sky4walk/BrausteuerungV4/Hardware/kicad/BrausteuerungV4_Prototypplatine/BrausteuerungV4_Prototypplatine.jpg

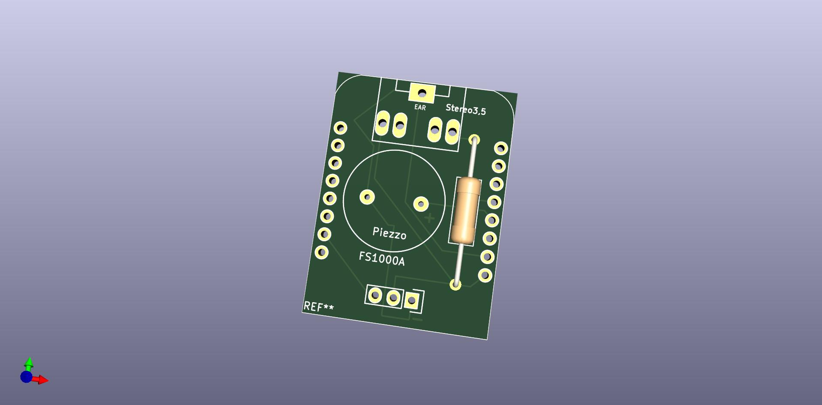
Hardware/kicad/BrausteuerungV4_Prototypplatine/BrausteuerungV4_Prototypplatine.jpg
