sky4walk/BrausteuerungV4/Documents/Bilder/WifiSetup1.jpg

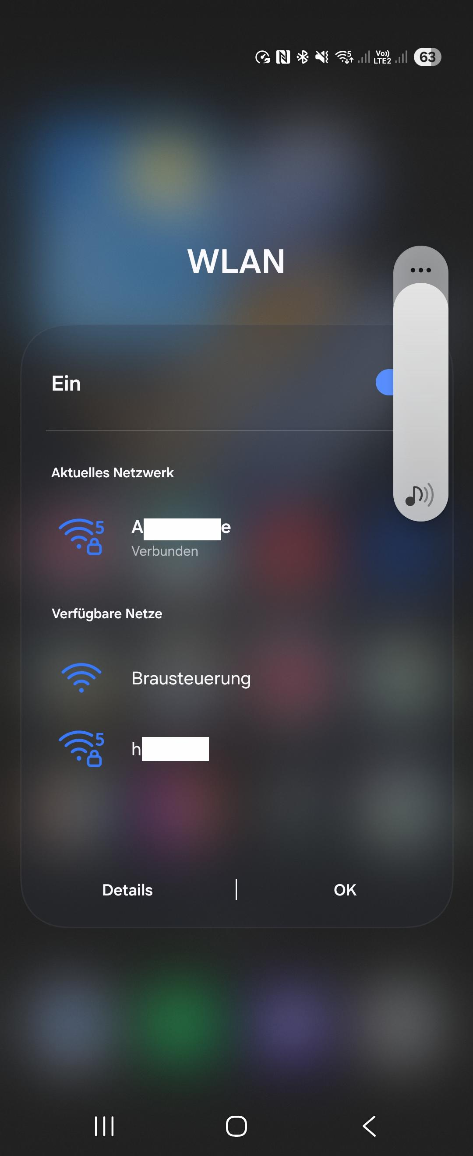
Documents/Bilder/WifiSetup1.jpg
