sky4walk/BrausteuerungV4/Readme.md

https://itzwieseltal.wordpress.com/2023/12/06/esp8266-brausteuerung/
