sky4walk/BrausteuerungV4/Documents/BrewBrick_Requirements.docx

🍺

BrewBrick

ESP8266 Brausteuerung

Technische Anforderungsdokumentation • Version 4.0.0

# 1. Projektübersicht

BrewBrick ist eine vollständige Heimbrausteuerung auf Basis des Wemos D1 Mini (ESP8266). Die Steuerung regelt die Heiztemperatur über einen PID-Regler und schaltet eine Funksteckdose per 433-MHz-Signal. Das Web-Interface ist vollständig im Flash des ESP gespeichert und über jeden Browser erreichbar.

Eigenschaft | Wert
Projektname | BrewBrick
Version | 4.0.0
Hardware | Wemos D1 Mini (ESP8266)
Web-Interface | http://brewbrick.local
AP-SSID | BrewBrick (offen, kein Passwort)
Projektseite | https://itzwieseltal.wordpress.com/2023/12/06/esp8266-brausteuerung/

# 2. Hardware

## 2.1 Microcontroller

Parameter | Wert
Board | LOLIN(WEMOS) D1 R2 & mini
Chip | ESP8266
Flash | 4MB (FS: 2MB, OTA: ~1MB)
Upload Speed | 921600 Baud
SSL | Basic SSL ciphers
Taktfrequenz | 80 MHz

## 2.2 Pin-Belegung

GPIO | Funktion
GPIO4 / D2 | DS18B20 Temperatursensor (OneWire)
GPIO0 / D3 | Buzzer (Piezo)
GPIO15 / D8 | RCSwitch 433MHz Sender

## 2.3 Angeschlossene Geräte

- DS18B20 Temperatursensor (OneWire, parasitär oder mit Pullup)
- Piezo-Buzzer für akustische Signale
- 433-MHz-Sender für Funksteckdose
- Funksteckdose mit Relais (EIN/AUS per RC-Signal)

# 3. Software & Bibliotheken

## 3.1 Arduino IDE Einstellungen

Board-Paket: esp8266 by ESP8266 Community v3.1.2

Board: LOLIN(WEMOS) D1 R2 & mini

Flash Size: 4MB (FS:2MB OTA:~1019KB)

SSL Support: Basic SSL ciphers (lower ROM, faster boot)

Upload Speed: 921600

## 3.2 Bibliotheken (Core — Teil des ESP8266-Pakets v3.1.2)

- ESP8266WiFi
- ESP8266WebServer
- ESP8266mDNS
- LittleFS
- ESP8266HTTPUpdateServer

## 3.3 Externe Bibliotheken

Bibliothek | Version / Autor
OneWire | v2.3.7 — Paul Stoffregen
DallasTemperature | v3.9.0 — Miles Burton
PID | v1.2.0 — Brett Beauregard
RCSwitch | v2.6.4 — sui77
ArduinoJson | v6.21.5 — Benoit Blanchon (unbedingt v6.x!)

# 4. LittleFS Dateisystem

Das LittleFS-Dateisystem belegt 2MB des Flash-Speichers und enthält alle persistenten Daten:

Datei | Inhalt
/wlan.json | WLAN Credentials (geschützt, nicht löschbar per API)
/config.json | RCSwitch Codes, PID-Parameter, alle Einstellungen
/rezept.bml | Aktuell geladenes Braurezept (BML-Format)
/index.html | Optionale Web-UI (überschreibt PROGMEM-Version)
/log.csv | Temperaturlog (wird beim Brauen geschrieben)

# 5. Web-Interface

## 5.1 Erreichbarkeit

- WLAN-Modus: http://brewbrick.local oder IP-Adresse
- AP-Modus: http://192.168.4.1 (SSID: BrewBrick, offen)
- mDNS-Name: brewbrick.local

## 5.2 Tabs

Tab | Funktion
Steuerung | Temperaturanzeige, Timer, Heizungsstatus, Live-Chart
Rezept Erstellen | BML-Editor, BeerXML-Import, Rezept übernehmen
Einstellungen | RCSwitch, PID, alle Parameter konfigurieren
⚙ Tools (Link) | HTML-Upload, OTA-Firmware, Backup/Restore, Reset
📝 Rezept Erstellen (Link) | BML-Generator auf GitHub Pages
🧮 Rechner (Link) | Braurechner auf GitHub Pages

## 5.3 Steuerung-Tab — Anzeige

- Ist-Temperatur, Soll-Temperatur, Gradient (°C/min), Zustand
- Heizungsanzeige (EIN/AUS) mit PID-Prozentsatz
- Live-Temperaturkurve (Canvas-Chart aus Flash-Log)
- Grüne Linie = Ist-Temperatur
- Gestrichelte Amber-Linie = Solltemperatur
- Rote Fläche = Heizleistung (PID-Output)
- Vertikale Linien = Rast-Wechsel
- Timer (verbleibend / gesamt) wenn Rast läuft
- Halt-Banner mit "Weiter" und "🔕 Stumm" Button
- Sensor-Fehler Banner (rot) wenn Sensor getrennt

## 5.4 API-Endpunkte

Endpunkt | Funktion
GET /api/status | Live-Status als JSON
POST /api/start | Rezept starten {von: nr}
POST /api/stop | Stoppen
POST /api/weiter | Halt bestätigen → nächste Rast
POST /api/call/mute | Piepen für aktuelle Rast stumm schalten
GET /api/config | Einstellungen lesen
POST /api/config | Einstellungen speichern
POST /api/heizung-test | Heizung testen {an: bool}
GET /api/log | Log als JSON (für Chart)
POST /api/log/reset | Log löschen
GET /api/log/download | Log als CSV herunterladen
GET /api/settings/backup | config.json herunterladen
GET /api/files | Dateilisting (wlan.json ausgeblendet)
POST /api/files/delete | Datei löschen (?name=datei.ext)
POST /api/rezept/loeschen | Rezept löschen
POST /api/wlan/reset | Komplett-Reset (alle Dateien löschen)
GET /api/sysinfo | System-Info
POST /upload/bml | BML hochladen
POST /upload/config | Config hochladen / Restore
POST /upload/html | HTML hochladen (.html oder .gz)
GET /update | OTA Firmware (admin/brau2024)
GET /tools | Tools-Seite (PROGMEM)

# 6. Brau-Logik

## 6.1 Zustandsmaschine

Zustand | Beschreibung
GESTOPPT (0) | Kein Rezept aktiv, Heizung aus
AUFHEIZEN (1) | Heizt auf Solltemperatur, Timer noch nicht gestartet
RAST_LAEUFT (2) | Solltemperatur erreicht, Timer läuft
WARTEN_HALT (3) | Timer abgelaufen, wartet auf "Weiter" (call=true)

## 6.2 Rast-Ablauf

- Aufheizen bis Solltemperatur erreicht (tempAktuell >= pidSetpoint)
- Timer startet sofort — kein manueller Eingriff nötig
- Timer läuft ab → call=true: 3x Piepen + warten auf "Weiter"
- "Weiter" klicken → nächste Rast startet
- call=false: sofort nächste Rast ohne Piepen
- Letzte Rast abgeschlossen: 5x Piepen

## 6.3 Halt / Call

Halt und Call werden als ein gemeinsamer Parameter behandelt. Ein Schieber im Rezept-Editor setzt beide gleichzeitig. Bedeutung:

- Call=false: Timer läuft ab → nächste Rast automatisch
- Call=true: Timer läuft ab → 3x Piepen → warten auf "Weiter"

## 6.4 Akustische Signale

Ereignis | Signal
Boot / Bereit (WLAN) | 2x Piepen
AP-Modus aktiv | 1x langer Piepton
Temperatur erreicht, Call=true | 3x Piepen (+ alle 10s Wiederholung)
Brauprogramm abgeschlossen | 5x Piepen
Sensor getrennt (nach 10s) | 5x Piepen
Stumm-Button gedrückt | Piepen gestoppt bis nächste Rast

## 6.5 Browser-Ton

- Web Audio API — kein Plugin nötig, funktioniert auf allen modernen Browsern
- Gleiche Logik wie ESP-Buzzer: 3x beim Rast-Ende, alle 10s Wiederholung
- 🔕 Stumm-Button stoppt Browser-Ton und ESP-Piepen für aktuelle Rast
- Erfordert einmaligen Klick auf die Seite (Browser-Policy)

# 7. PID-Regelung

## 7.1 Parameter

Parameter | Standardwert / Beschreibung
Kp | 5.0 — Proportionalanteil
Ki | 0.05 — Integralanteil
Kd | 10.0 — Differentialanteil
PID-Fenster | 30 Sekunden (konfigurierbar 5–120s)
PID-Schwellwert | 5°C — unter (Soll - 5°C) → 100% Leistung
Sample Time | 2000ms

## 7.2 Schwellwert-Logik

- Wenn (Soll - Ist) > Schwellwert → 100% Leistung (kein PID)
- Wenn (Soll - Ist) <= Schwellwert → PID übernimmt
- Schwellwert = 0 → PID regelt von Anfang an
- Ziel: Vermeidung von D-Anteil-Bremsung beim Aufheizen

## 7.3 Rast-spezifische PID-Werte

- Jede Rast kann eigene PID-Werte haben (Toggle "Eigene PID-Werte")
- Flag OwnPid=true im BML → Rast-Werte werden verwendet
- Flag OwnPid=false → globale Einstellungswerte werden verwendet
- PID wird bei jeder neuen Rast zurückgesetzt (MANUAL → AUTOMATIC)

## 7.4 MaxGradient

- Pro Rast einstellbarer maximaler Temperaturanstieg in °C/min
- MaxGradient = 0 → keine Begrenzung, volle Leistung erlaubt
- MaxGradient > 0 → PID-Output wird proportional reduziert wenn Gradient zu hoch

# 8. RCSwitch / Funksteckdose

## 8.1 Standardwerte

Parameter | Standardwert
Code EIN | 1631343
Code AUS | 1631342
Protokoll | 1
Pulslänge | 315 µs
Bits | 24
Sendeversuche | 15
Wiederholungsintervall | 10 Sekunden
Relais Mindest-Schaltzeit | 200ms (Relais-Schutz)

## 8.2 Signal-Wiederholung

- Alle 10 Sekunden wird das aktuelle Signal (EIN oder AUS) wiederholt
- Gilt auch im Standby: immer AUS-Signal senden
- Verhindert falschen Zustand bei verlorenen Funksignalen

## 8.3 Relais-Schutz

- Mindest-Schaltzeit verhindert zu schnelles Schalten des Relais
- Standard: 200ms — verhindert Verschleiß bei schnellem PID-Takten
- Konfigurierbar 0–5000ms in den Einstellungen

# 9. Temperatursensor

- DS18B20 OneWire-Sensor an GPIO4 / D2
- Messintervall: 2 Sekunden
- Gradient wird aus den letzten 6 Messungen (12s) berechnet in °C/min
- Sensor-Fehler nach 10s ohne gültige Messung:
- Heizung wird sofort abgeschaltet
- 5x Piepen als Alarm
- Rotes Banner im Browser
- Sensor wieder eingesteckt → automatische Erkennung, kein Neustart nötig

# 10. Temperaturlogging

- Logging startet automatisch beim ersten Rast-Start
- Logging stoppt beim Stop oder nach letzter Rast
- Schreibt alle 10 Sekunden in /log.csv auf LittleFS
- Format: Zeit_s;Temp_C;Soll_C;PID_Pct;Rast
- 💾 Log Button im Browser → direkter CSV-Download
- ↺ Reset löscht die Log-Datei und setzt den Chart zurück
- Log überlebt Neustart (bleibt bis manuell gelöscht oder Reset)

# 11. Rezept-Format (BML)

## 11.1 BML-Datei

Das Rezept wird im BML-Format (XML-basiert) gespeichert. BML steht für Brau-Markup-Language und ist kompatibel mit der MikroSikaru App.

## 11.2 Rast-Parameter

Parameter | Beschreibung
Name | Rastname (leer → automatisch "Rast N")
On | true/false — Rast aktiv
Halt/Call | true/false — Piepen + warten am Rast-Ende
SollTemp | Zieltemperatur in °C
Time | Rastdauer in Minuten
MinTemp / MaxTemp | Toleranzbereich (±°C)
MaxGradient | Max. Aufheizrate in °C/min (0 = unbegrenzt)
OwnPid | true = eigene PID-Werte verwenden
Kp / Ki / Kd | Rast-spezifische PID-Parameter
Info | Notizfeld für Brauer

## 11.3 Rezept-Editor

- Direkt integriert im Tab "Rezept Erstellen"
- Bis zu 16 Rasten erstellbar
- BML-Import und -Export
- BeerXML-Import (konvertiert Mash Steps automatisch)
- "Rezept übernehmen" lädt BML direkt auf den ESP
- Beim Tab-Öffnen werden aktuelle ESP-Rasten automatisch geladen

# 12. WLAN & Netzwerk

- WLAN-Config in /wlan.json (geschützt)
- Verbindungsversuch beim Start: 15 Sekunden Timeout
- Kein WLAN gefunden → AP-Modus: SSID "BrewBrick" (offen)
- AP-IP: 192.168.4.1
- WLAN-Einrichtung über Web-Formular im AP-Modus
- mDNS-Hostname: brewbrick → http://brewbrick.local
- WLAN-Reset: /tools → "⚠ Alles löschen & Neustart" (löscht alle Dateien)

# 13. OTA-Updates & Werkzeuge

## 13.1 Firmware OTA

- URL: http://brewbrick.local/update (Login: admin / brau2024)
- Auch über /tools → "⚡ Flashen" Button
- Arduino IDE: Sketch → Exportiere kompilierte Binärdatei → .bin hochladen
- Sketch-Größe ~400KB < OTA-Bereich 1019KB → passt

## 13.2 HTML-Update

- URL: http://brewbrick.local/tools → "⬆ Upload" Button
- Oder per curl: curl -X POST http://brewbrick.local/upload/html -F "file=@index.html"
- LittleFS-Version hat Vorrang vor eingebetteter PROGMEM-Version
- "↺ Reset" in /tools aktiviert wieder die PROGMEM-Version

## 13.3 Flash-Script (Linux)

flash_esp.sh im Sketch-Verzeichnis sucht automatisch die neueste .bin Datei und den USB-Port:

Verwendung: ./flash_esp.sh

Erkennt: /dev/ttyUSB0, /dev/ttyUSB1, /dev/ttyACM0, /dev/ttyACM1

Tool: esptool (sudo apt install esptool)

## 13.4 File-Management per curl

Dateilisting: curl http://brewbrick.local/api/files

Datei löschen: curl -X POST "http://brewbrick.local/api/files/delete?name=log.csv"

Log herunterladen: curl http://brewbrick.local/api/log/download -o log.csv

Config Backup: curl http://brewbrick.local/api/settings/backup -o config.json

Config Restore: curl -X POST http://brewbrick.local/upload/config -F "file=@config.json"

# 14. Erstinbetriebnahme

- Sketch mit Arduino IDE kompilieren und per USB flashen
- Board: LOLIN(WEMOS) D1 R2 & mini
- Flash Size: 4MB (FS:2MB OTA:~1019KB)
- SSL: Basic SSL ciphers
- ESP startet im AP-Modus: SSID "BrewBrick"
- Mit "BrewBrick" verbinden (kein Passwort)
- Browser öffnen: http://192.168.4.1
- Setup-Seite erscheint: index.html hochladen
- WLAN konfigurieren: SSID und Passwort eingeben
- ESP verbindet sich → http://brewbrick.local aufrufen
- Einstellungen: RCSwitch-Codes, PID-Parameter konfigurieren
- Rezept erstellen oder BML-Datei hochladen
- Sud starten! 🍺

# 15. Hinweise & Einschränkungen

- IRAM-Auslastung ~94% — stabil, aber wenig Puffer für weitere Libraries
- RC433 ist ein One-Way-Protokoll — keine Rückmeldung ob Steckdose empfangen hat
- Temperaturlog: Flash-Speicher hat ~100.000 Schreibzyklen — bei 10s Intervall ~16 Jahre Lebensdauer
- mDNS (brewbrick.local) auf Android nicht immer zuverlässig — IP-Adresse als Fallback verwenden
- Browser-Ton erfordert einmaligen Klick auf die Seite (Browser-Autoplay-Policy)
- OTA-Update schreibt in den OTA-Bereich — LittleFS-Dateien bleiben erhalten

ESP8266 Brausteuerung | /

BrewBrick v4.0.0 — Technische Anforderungsdokumentation
