sky4walk/BrausteuerungV4/Documents/ArduinoIDE-ESP8266.odp

  ESP8266 mit der Arduino IDE entwickeln
  info@AndreBetz.de

## Slide 2

Installationspackete

- http://www.arduino.org/downloads Arduino IDE

- http://arduino.esp8266.com/stable/package_esp8266com_index.json Arduino AddOn

- http://esp8266.com/arduino ESP8266 Projektverzeichnis

- https://github.com/esp8266/Arduino

- https://github.com/esp8266/Arduino/releases/download/2.3.0/esp8266-2.3.0.zip ESP8266 Bibliotheken

- http://esp8266.github.com/Arduino/versions/2.3.0/

- https://github.com/esp8266/Arduino/releases/download/2.3.0/win32-xtensa-lx106-elf-gb404fb9-2.tar.gz Windows Compiler für ESP8266

## Slide 3

Unter Datei→Voreinstellgen den Link unten einfügen

http://arduino.esp8266.com/stable/package_esp8266com_index.json

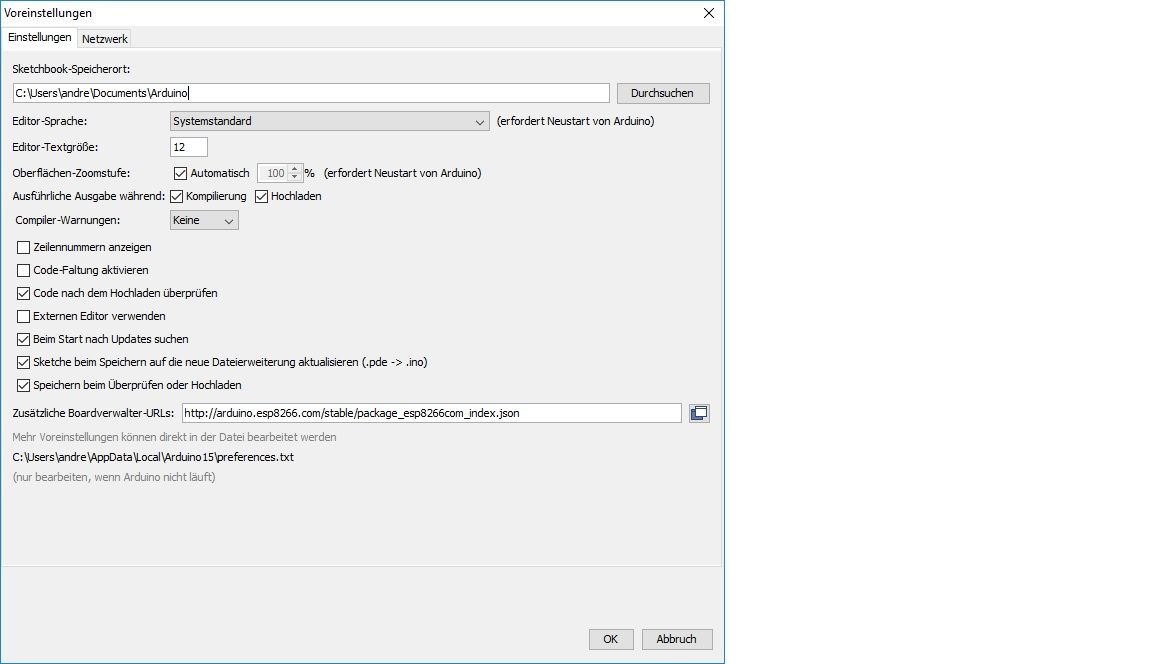
[picture p3: figure]

## Slide 4

Werkzeuge→Board→Boardverwalter

Esp8266 installieren

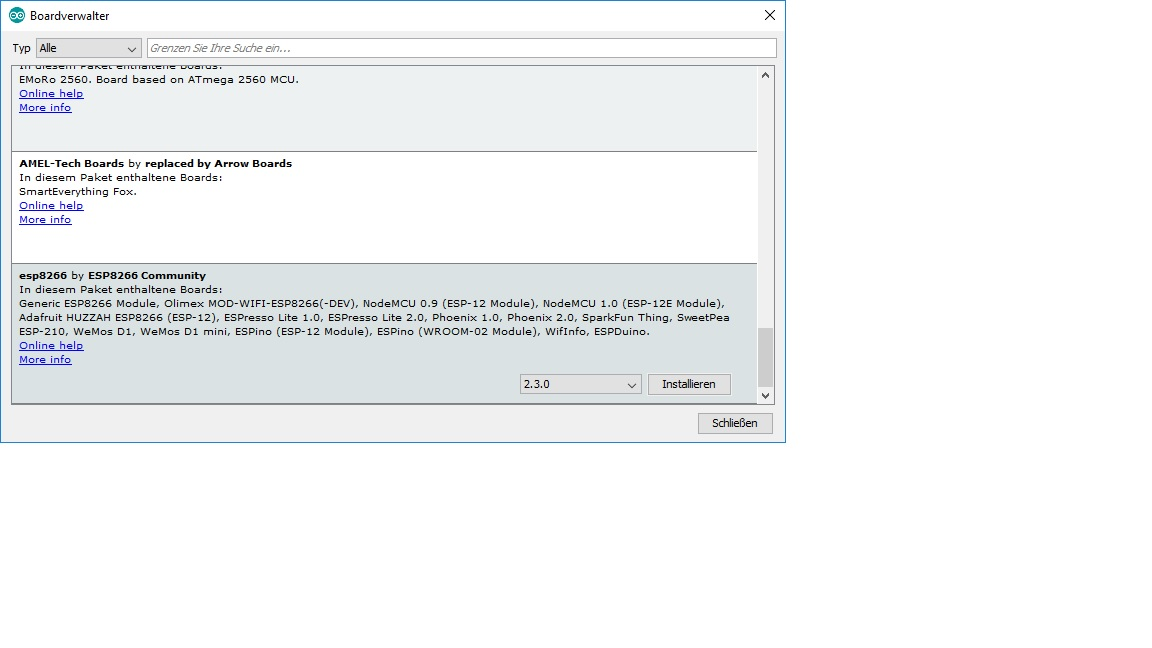
[picture p4: figure]

## Slide 5

Auswahl des ESP8266 NodeMCU Boardes

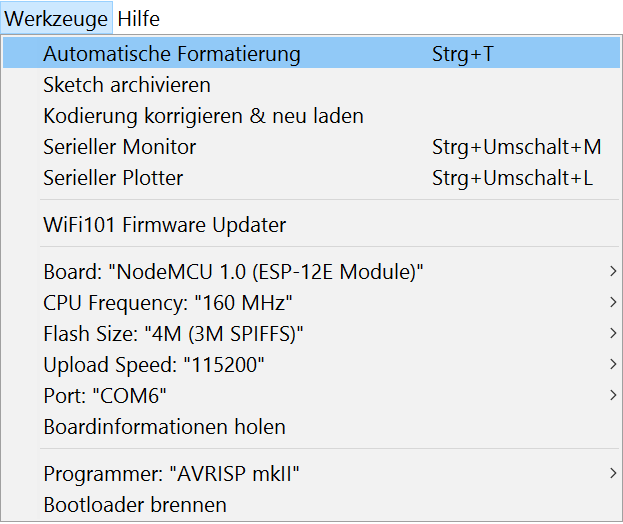
[picture p5: figure]
