sky4walk/BrausteuerungV4/Case/Box.png

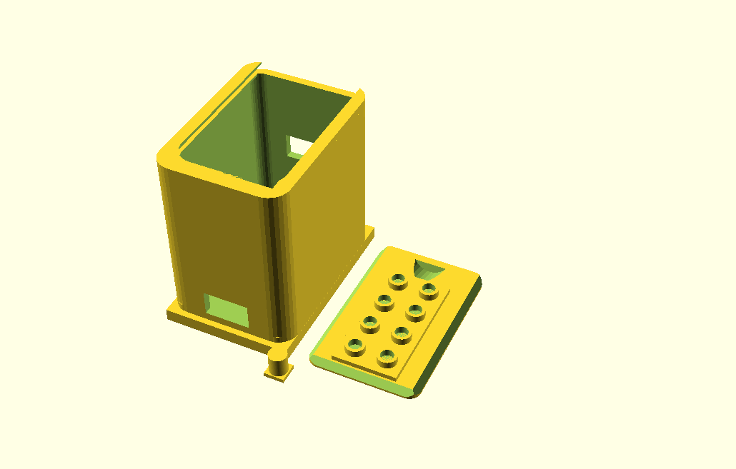
Case/Box.png
