sky4walk/BrausteuerungV4/Case/holder.png

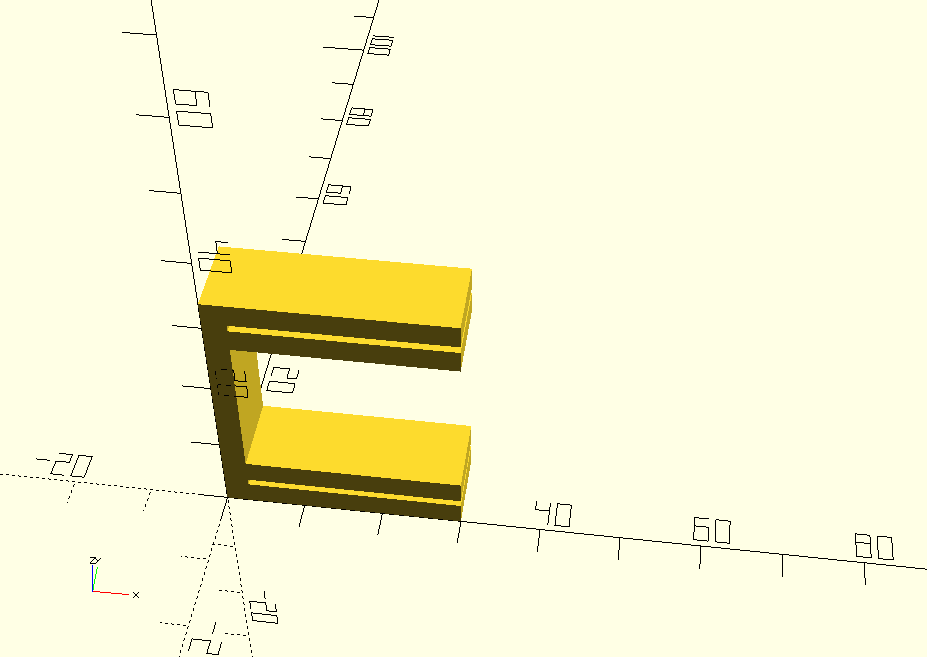
Case/holder.png
