sky4walk/BrausteuerungV4/Documents/Bilder/Brausteuerung01.png

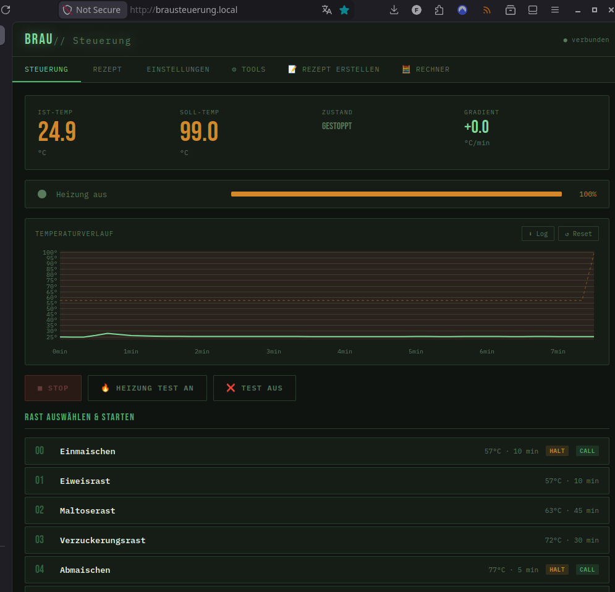
Documents/Bilder/Brausteuerung01.png
