sky4walk/BrausteuerungV4/Documents/Bilder/Brausteuerung02.png

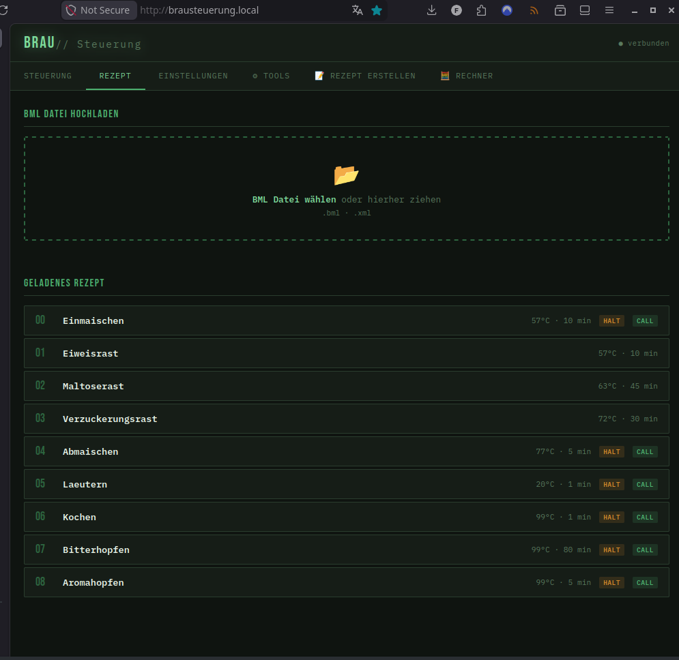
Documents/Bilder/Brausteuerung02.png
