sky4walk/BrausteuerungV4/Documents/Bilder/Brausteuerung03.png

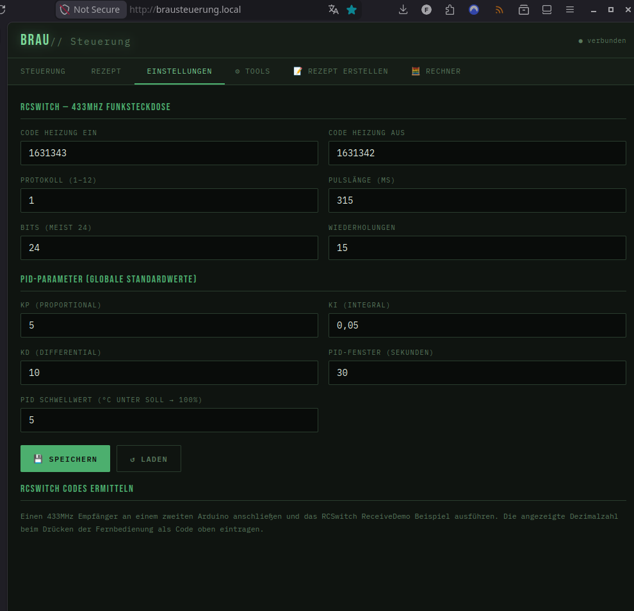
Documents/Bilder/Brausteuerung03.png
