sky4walk/BrausteuerungV4/Documents/Bilder/Brausteuerung04.png

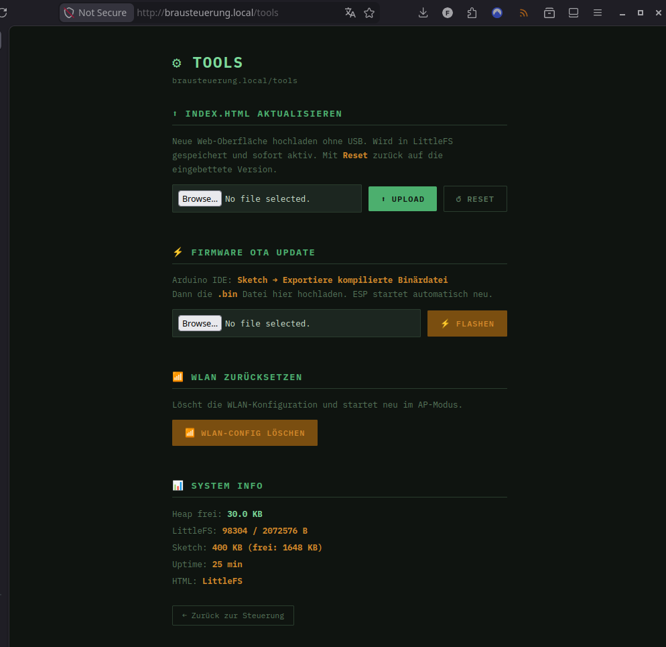
Documents/Bilder/Brausteuerung04.png
