sky4walk/BrausteuerungV4/Documents/Bilder/Brausteuerung05.png

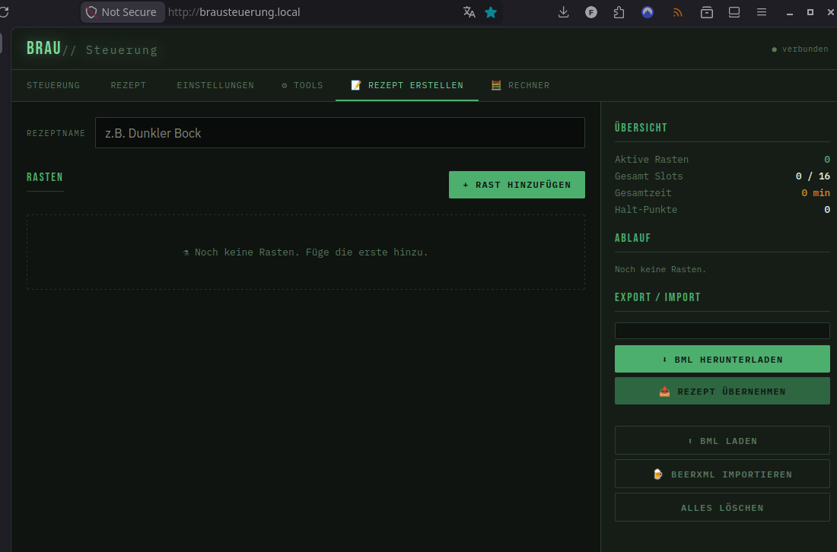
Documents/Bilder/Brausteuerung05.png
