sky4walk/BrausteuerungV4/Documents/Bilder/Brausteuerung06.png

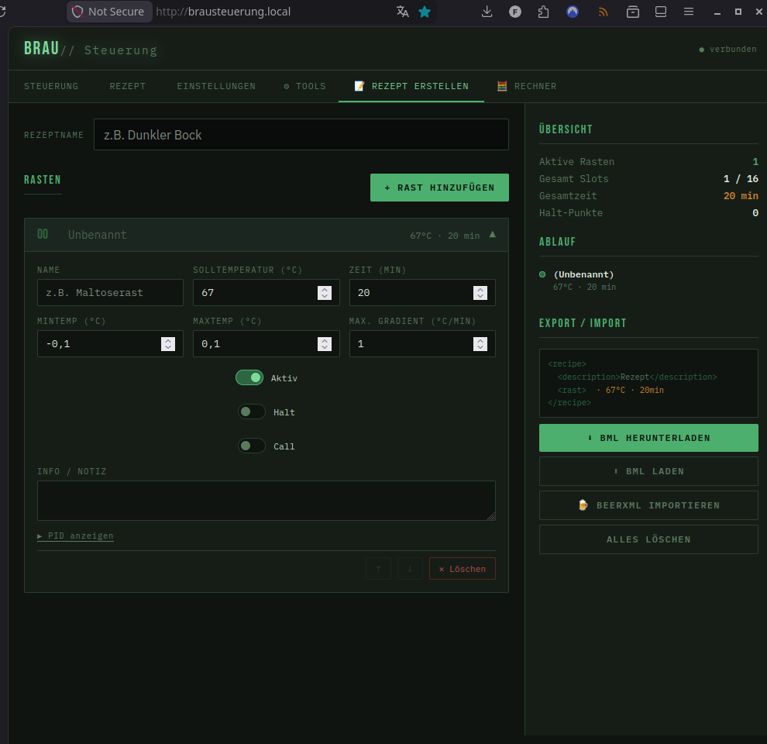
Documents/Bilder/Brausteuerung06.png
