sky4walk/BrausteuerungV4/Documents/Bilder/Brausteuerung07.png

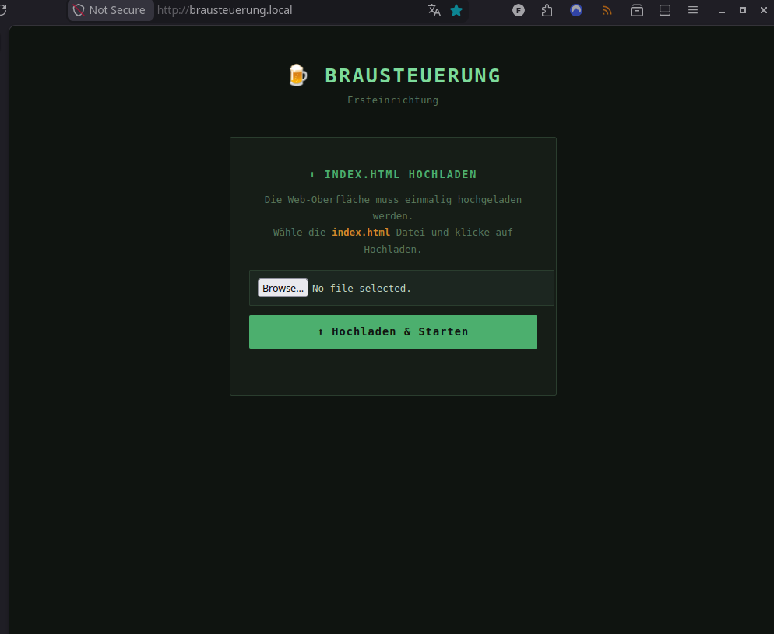
Documents/Bilder/Brausteuerung07.png
