sky4walk/BrausteuerungV4/Documents/Bilder/Brausteuerung08.png

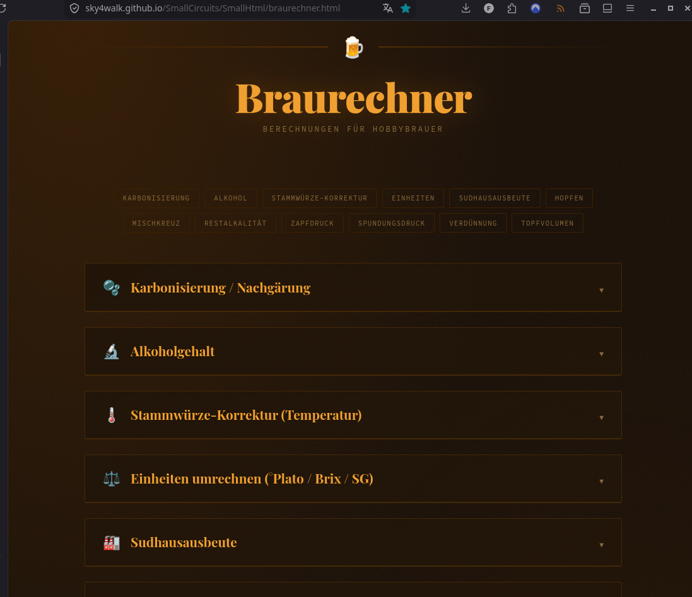
Documents/Bilder/Brausteuerung08.png
