sky4walk/BrausteuerungV4/Hardware/Dallas-DS18B20.jpg

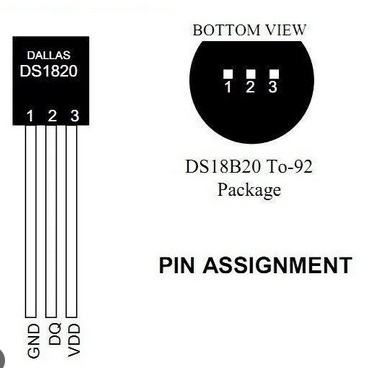
Hardware/Dallas-DS18B20.jpg
