sky4walk/BrausteuerungV4/Hardware/fritzing/BrausteuerungV4b_Steckplatine.jpg

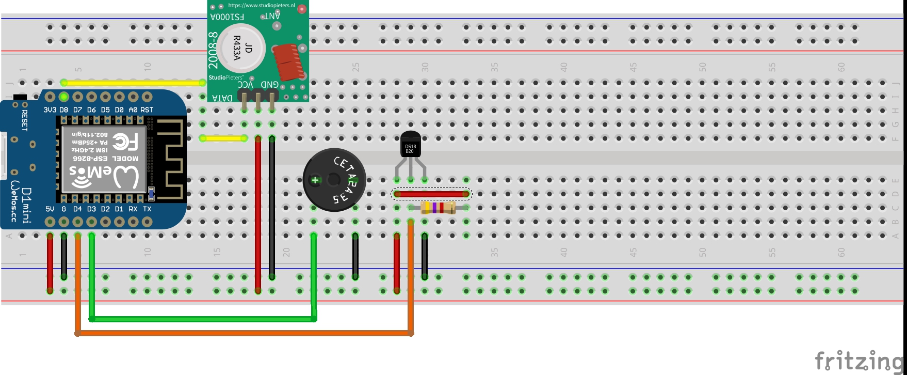
Hardware/fritzing/BrausteuerungV4b_Steckplatine.jpg
