sky4walk/BrausteuerungV4/Hardware/fritzing/TX433MHz-Receiver-MX-RM-5V.jpg

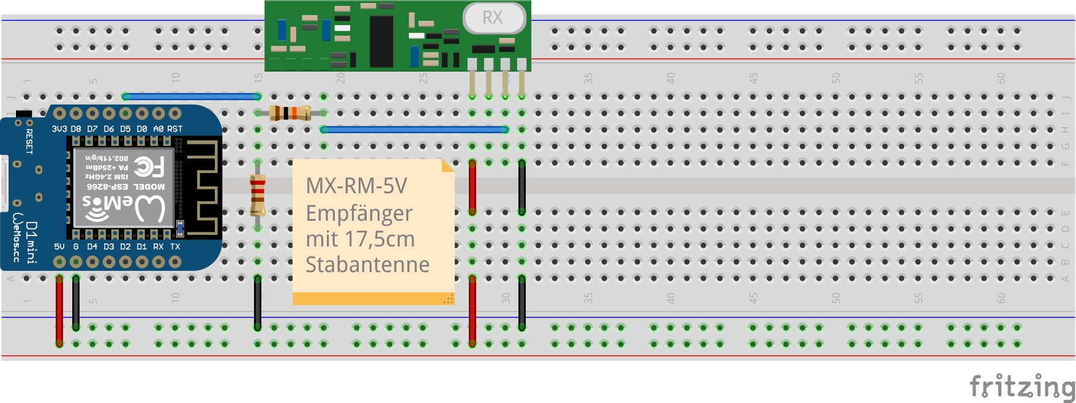
Hardware/fritzing/TX433MHz-Receiver-MX-RM-5V.jpg
