sky4walk/BrausteuerungV4/Documents/Bauteilliste.ods

Anzahl benötigt | Bezeichnung | Anbieter | Enthalten | Preis komplett | Versandkosten | Versandkosten anteilig | Preis benötigt | Preis mit Versand
1 | NodeMCU ESP8266 | https://www.amazon.de/MagiDeal-Nodemcu-Esp8266-Internet-Entwicklungs/dp/B01KKH26L8 | 1 | 4,92 | 0 | 0 | 4,92 | 4,92
1 | Transmitter 433MHz | https://www.amazon.de/XCSOURCE-Transmitter-Receiver-Arduino-TE122/dp/B00V4ISS38 | 5 | 6,89 | 0 | 0 | 1,378 | 1,378
1 | DS18B20 wasserdicht 2Meter | https://www.amazon.de/Temperaturfuehler-Wasserdicht-Digital-Temperatur-DS18b20/dp/B01CTXWYVI | 10 | 19,66 | 0 | 0 | 1,966 | 1,966
1 | Piezzo Buzzer | http://www.amazon.de/gp/product/B00J4BK0NS?psc=1&redirect=true&ref_=oh_aui_detailpage_o00_s00 | 20 | 5,21 | 0 | 0 | 0,2605 | 0,2605
1 | Gehäuse KEMO GEH KSB 01B 101x60x26 (G01B 9V) | https://www.reichelt.de/index.html?ACTION=3;ARTICLE=73220;SEARCH=GEH%20KSB%2001B | 30 | 1,65 | 4,99 | 0,1663333333333 | 0,055 | 0,2213333333333
1 | 9V Batterieclip | http://www.amazon.de/gp/product/B00HUH9IWM | 20 | 2,65 | 0 | 0 | 0,1325 | 0,1325
1 | Widerstand 4,7KOhm DS18B20 | https://www.amazon.de/Widerstand-St%C3%BCck-Kohleschicht-Widerst%C3%A4nde-Resistor/dp/B00IYTM6O2 | 30 | 1,29 | 1,99 | 0,0663333333333 | 0,043 | 0,1093333333333
1 | Widerstand 220Ohm | https://www.amazon.de/Just-Honest-Widerstand-0-25W-Resistor-Carbon/dp/B00YW0HLP6?s=ce-de | 200 | 5,49 | 0 | 0 | 0,02745 | 0,02745
1 | 1N5817 DO-41 Schottky-Gleichrichter-Dioden 20V 1A (https://www.amazon.de/gp/product/B01EZZMSKA/ref=oh_aui_detailpage_o00_s00?ie=UTF8&psc=1) | https://www.amazon.de/gp/css/order-history/ref=nav_youraccount_orders | 80 | 5,73 | 2 | 0,025 | 0,071625 | 0,096625
1 | Mini Kipp Schalter | https://www.amazon.de/gp/product/B00HGAKDIQ/ref=ox_sc_act_title_1?smid=A3JWKAKR8XB7XF&psc=1 | 10 | 4,25 | 0 | 0 | 0,425 | 0,425
1 | Arendo - Funksteckdosen-Set (3+1) | https://www.amazon.de/gp/product/B01GQFJVC0/ref=oh_aui_detailpage_o04_s00?ie=UTF8&psc=1 | 3 | 16,85 | 0 | 0 | 5,6166666666667 | 5,6166666666667
1 | 10 x Kabeldurchführungstülle, Gummitülle, Kabeltülle, Kabelschutz, KD: 4mm ID: 6,2mm | https://www.amazon.de/10-Kabeldurchf%C3%BChrungst%C3%BClle-Gummit%C3%BClle-Kabelt%C3%BClle-Kabelschutz/dp/B00P8ZUQ8I | 10 | 1,99 | 2,5 | 0,25 | 0,199 | 0,449
0,1 | Sekundenkleber | http://www.amazon.de/gp/product/B00M94A20I?keywords=sekundenkleber&qid=1449411101&ref_=sr_ph&sr=1 | 5 | 2,79 | 1 | 0,02 | 0,0558 | 0,2558
0,001 | Draht schwarz (keine versandkosten schon oben) | http://www.amazon.de/Farbige-Kupferschaltlitze-Isolierung-1adrig-Farbe/dp/B0019R2WFE?s=diy | 10 | 3,03 | 0 | 0 | 0,000303 | 0,000303
0,002 | Draht rot (keine versandkoste schon oben drin) | http://www.amazon.de/Farbige-Kupferschaltlitze-Isolierung-1adrig-Farbe/dp/B0019R2WFE?s=diy | 10 | 3,03 | 0 | 0 | 0,000606 | 0,100606
0,1 | Lötzinn | http://www.amazon.de/Silverline-AS15-L%C3%B6tzinn-100-g/dp/B000LFTN1G?s=diy | 100 | 4,73 | 0 | 0 | 0,00473 | 0,00473
1 | LED als Power on indikator | http://www.amazon.de/Green-Yellow-Assorted-Emitting-Diodes/dp/B0087ZT1VO | 75 | 2,35 | 0 | 0 | 0,0313333333333 | 0,0313333333333
1 | DIP-4 Drucktaster 6x6x5mm DC12V 50mA | https://www.amazon.de/gp/product/B00D82M9LA/ref=oh_aui_search_detailpage?ie=UTF8&psc=1 | 100 | 1,28 | 1 | 0,01 | 0,0128 | 0,0228
0,001 | Isolierband - Länge 25mt. - Breite 15mm. - Schwarz | https://www.amazon.de/Isolierband-L%C3%A4nge-25mt-Breite-Schwarz/dp/B00EAQPH2Q?s=diy | 25 | 4,4 | 0 | 0 | 0,000176 | 0,000176
1 | Platine | elecrow.com | 50 | 44,48 | 23,21 | 0,4642 | 0,8896 | 1,3538
1 | Typenschild | Wir-machen-druck.de | 75 | 12,9 | 3,9 | 0,052 | 0,172 | 0,224
1 | Karton | https://www.bb-verpackungsshop.de/faltkarton-200-x-150-x-90-mm-p-36.html | 100 | 27,25 | 4,64 | 0,0464 | 0,2725 | 0,3189
3 | Papier (Rechnung+Infozettel + Versandetikett) | https://www.amazon.de/Hewlett-Packard-CHP350-Laserpapier-HP-Colour-Laser-Blatt/dp/B000H80CXA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 | 500 | 8,66 | 0 | 0 | 0,05196 | 0,05196
1 | Versand DHL Versichert 2kg | dhl.de | 1 | 4,99 | 0 | 0 | 4,99 | 4,99
1 | Kabelbinder | https://www.amazon.de/GW-Kabelbinder-Technik-GT-200M-Kabelbinder-schwarz/dp/B00O0N9EXM?s=diy | 100 | 4,99 | 0 | 0 | 0,0499 | 0,0499
0,3 | BB-Verpackungen Luftpolsterfolie, 0,5 x 50 m | https://www.amazon.de/BB-Verpackungen-Luftpolsterfolie-Noppenfolie-Blisterfolie-Polstermaterial/dp/B004UEX7KC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 | 50 | 13,9 | 0 | 0 | 0,0834 | 0,0834
 | Summe |  |  |  | 45,23 | 1,1002666666667 | 44,5333666666667 | 23,0901166666667
Summe | 0
