sky4walk/BrausteuerungV4/Hardware/kicad/BrausteuerungV4_Prototypplatine/BrausteuerungV4_Prototypplatine.csv

ID | Bezeichner | Gehäuse | Stückzahl | Bezeichnung | Anbieter und Referenz
1 | R4,7K | R_Axial_DIN0309_L9.0mm_D3.2mm_P20.32mm_Horizontal | 1 | R_Axial_DIN0309_L9.0mm_D3.2mm_P20.32mm_Horizontal
2 | Piezzo | PIEZO-MCKPI-G1410 | 1 | PIEZO-MCKPI-G1410
3 | REF** | Wemos_D1_Mini_Shield | 1 | D1_mini_board
4 | Stereo3,5 | Tayda_3.5mm_stereo_TRS_jack_A-853 | 1 | EAR
5 | FS1000A | RF_Transmitter_433_MHz | 1 | RF_Transmitter_433_MHz
