sky4walk/BrausteuerungV4/Case/Box.stl

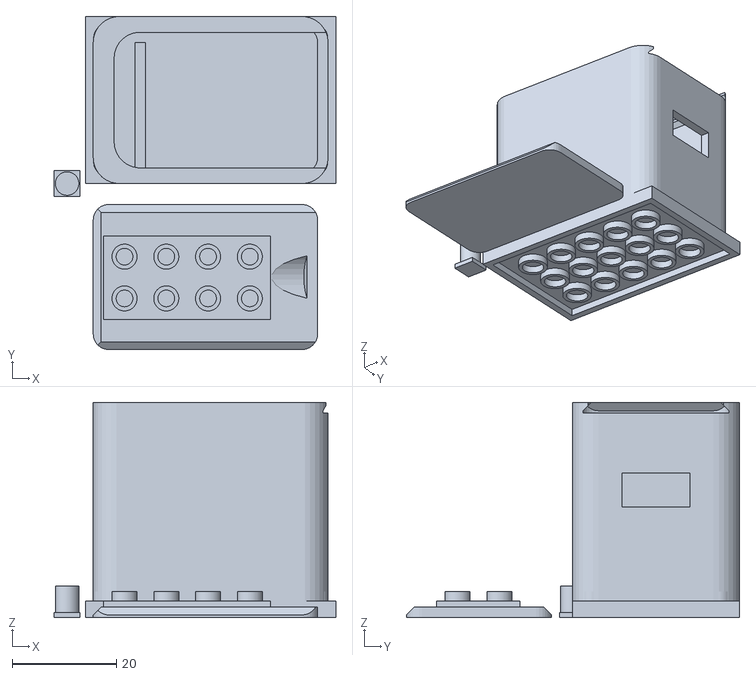
[picture p19: CAD file, 2026-09-27]
Case/Box.stl
54.0 x 63.8 x 41.2
