sky4walk/BrausteuerungV4/Case/holder.stl

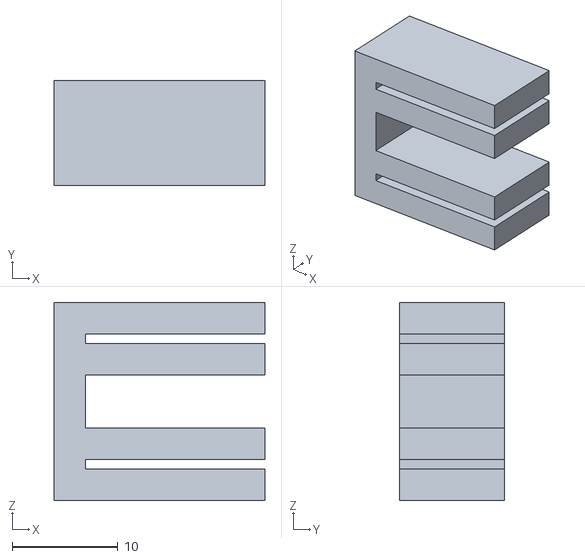
[picture p20: CAD file, 2024-07-04]
Case/holder.stl
20.0 x 10.0 x 18.8
