sky4walk/BrausteuerungV4/Case/Knob.stl

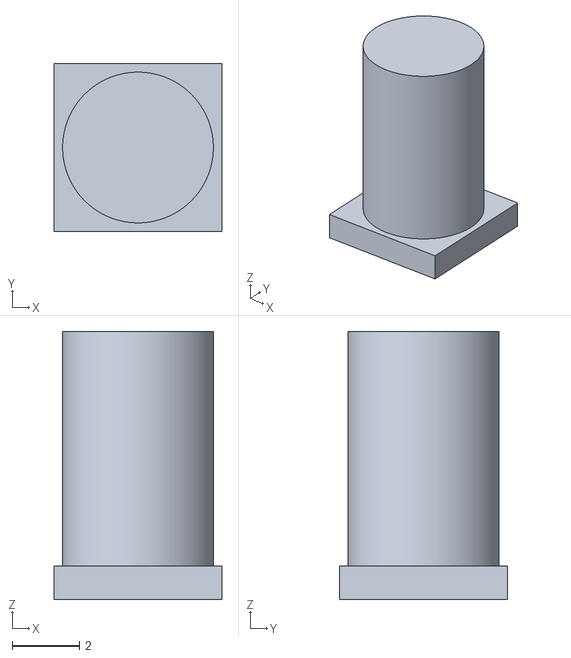
[picture p21: CAD file, 2023-12-14]
Case/Knob.stl
5.00 x 5.00 x 8.00
