sky4walk/BrausteuerungV4/Case/Lid.stl

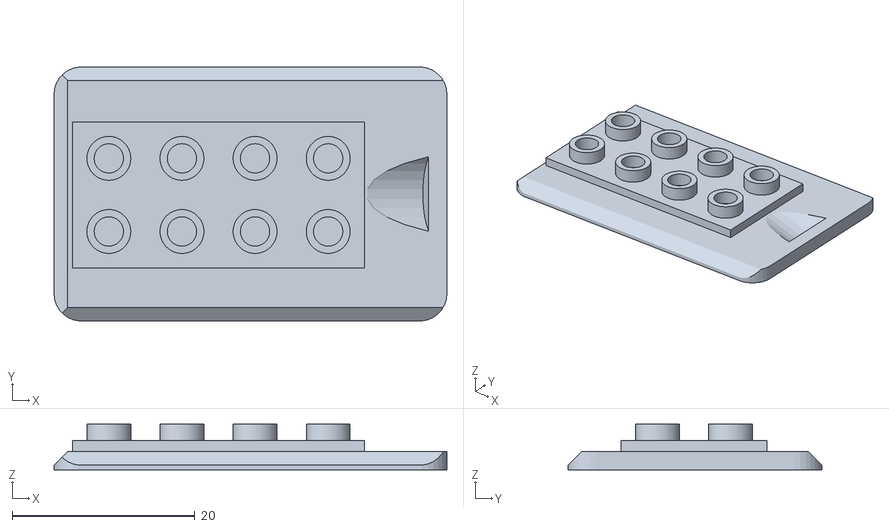
[picture p22: CAD file, 2023-11-27]
Case/Lid.stl
43.0 x 27.8 x 5.00
