sky4walk/BrausteuerungV4/Documents/Bilder/WifiSetup2.jpg

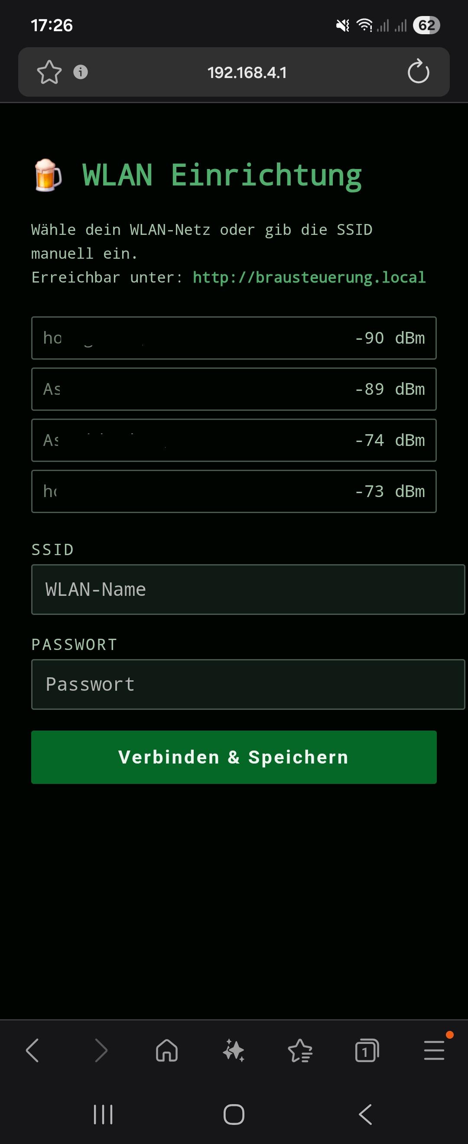
Documents/Bilder/WifiSetup2.jpg
