sky4walk/BrausteuerungV4/Hardware/kicad/BrausteuerungV4_Prototypplatine/BrausteuerungV4_Prototypplatine-B_Cu.pdf

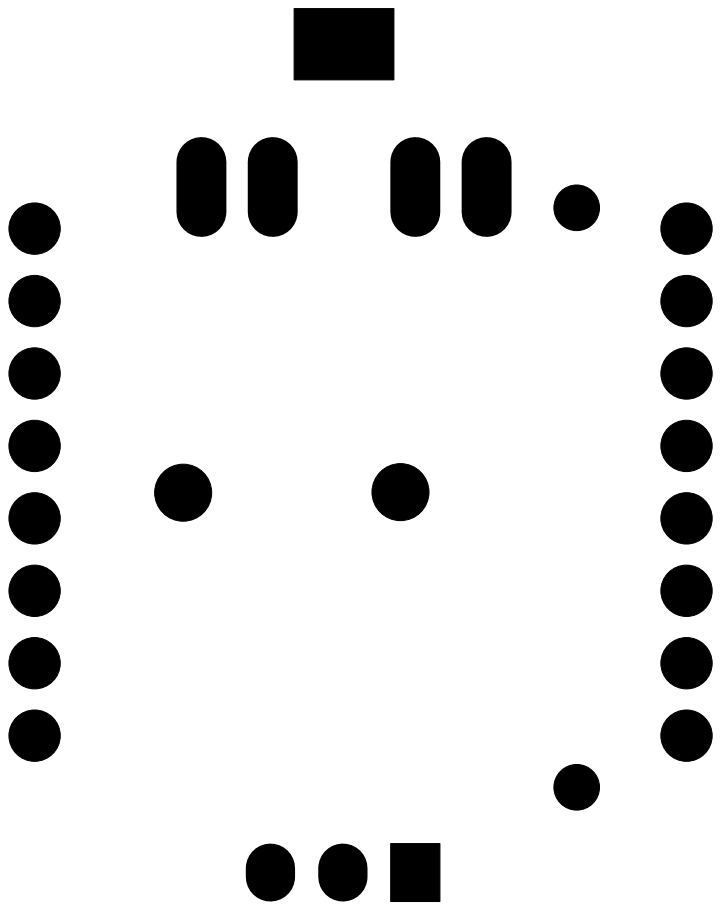
[picture p24: page 1]
