sky4walk/BrausteuerungV4/Hardware/kicad/BrausteuerungV4_Prototypplatine/BrausteuerungV4_Prototypplatine-F_Cu.pdf

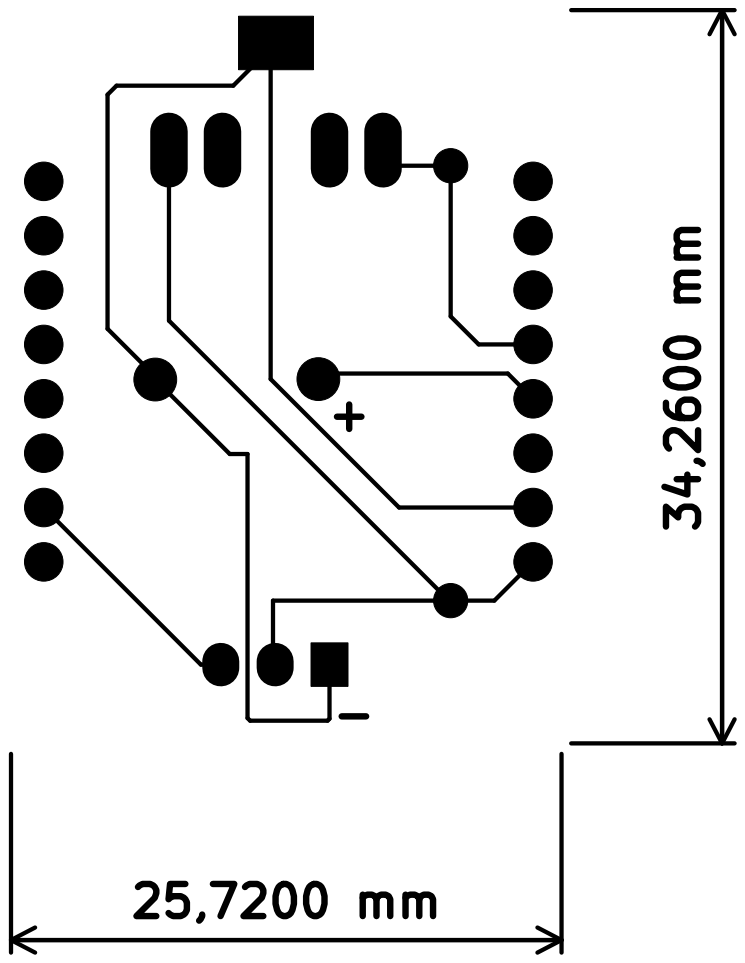
[picture p25: page 1]
