sky4walk/BrausteuerungV4/Hardware/kicad/BrausteuerungV4_Prototypplatine/BrausteuerungV4_Prototypplatine-F_Silkscreen.pdf

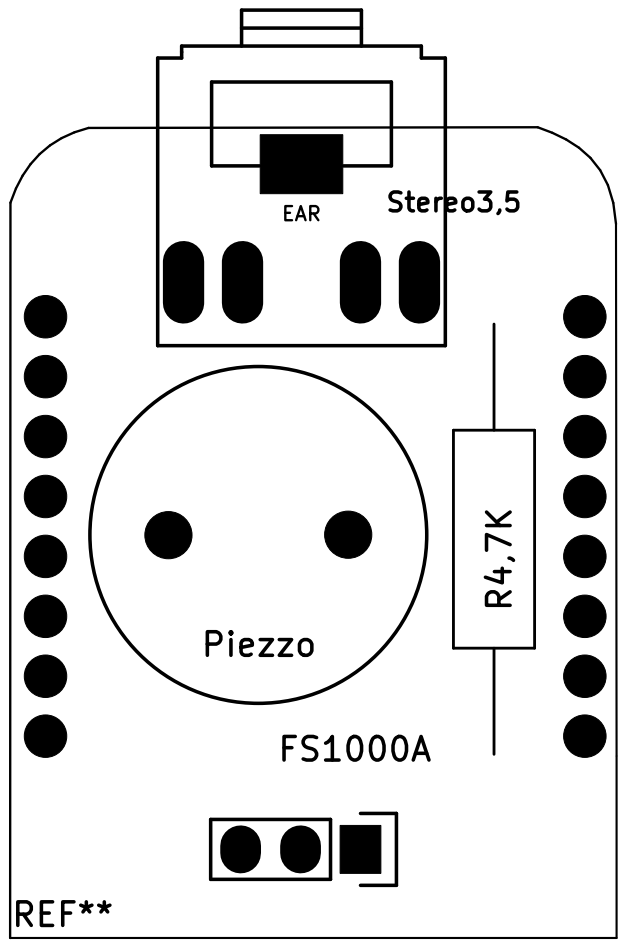
[picture p26: page 1]
