sky4walk/BrausteuerungV4/(list of files, drawings)

Other design files:
Hardware/fritzing/BrausteuerungV4b.fzz
Hardware/fritzing/RF Transmitter attiny85 Receiver arduino uno.fzz
Hardware/fritzing/TX433MHz-Receiver-MX-RM-5V.fzz
