sky4walk/BrausteuerungV4/Software/src/Steuerung/Steuerung.ino

/*
 * ╔══════════════════════════════════════════════════════════╗
 * ║              BREWBRICK — Wemos D1 Mini                  ║
 * ║  DS18B20 → D2 | Buzzer → D3 | RCSwitch → D8            ║
 * ╚══════════════════════════════════════════════════════════╝
 *
 * Board-Paket:  esp8266 by ESP8266 Community  v3.1.2
 * Board:        LOLIN(WEMOS) D1 R2 & mini
 * Flash Size:   4MB (FS: 2MB, OTA: ~1MB)
 * Upload Speed: 921600
 * SSL:          Basic SSL ciphers
 *
 * Bibliotheken (Arduino IDE → Bibliotheken verwalten):
 *   Core (Teil des ESP8266-Pakets v3.1.2):
 *   - ESP8266WiFi
 *   - ESP8266WebServer
 *   - ESP8266mDNS
 *   - LittleFS
 *   - ESP8266HTTPUpdateServer
 *
 *   Extern (manuell installieren):
 *   - OneWire           v2.3.7  (Paul Stoffregen)
 *   - DallasTemperature v3.9.0  (Miles Burton)
 *   - PID               v1.2.0  (Brett Beauregard)
 *   - RCSwitch          v2.6.4  (sui77)
 *   - ArduinoJson       v6.21.5 (Benoit Blanchon) ← unbedingt v6.x!
 *
 * Web-Interface:
 *   - index.html  → LittleFS (/index.html), sonst Setup-Seite
 *   - /tools      → Upload von index.html und Firmware OTA
 *   - /update     → ESP8266HTTPUpdateServer OTA (admin/brau2024)
 *
 * LittleFS Dateien:
 *   - /config.json  → RCSwitch Codes, PID-Parameter
 *   - /wlan.json    → WLAN Credentials
 *   - /rezept.json  → aktuell geladenes Braurezept (vom Browser geparst)
 *   - /index.html   → optionale Web-UI (überschreibt PROGMEM)
 *   - /log.csv      → Temperaturlog (wird beim Brauen geschrieben)
 *
 * Reset (per /tools → Komplett-Reset):
 *   Löscht alle LittleFS Dateien → Werksreset
 *
 * Version: 4.3.0
 *
 * 4.3.0: Kühlen. Jede Rast hat einen Modus (0 Heizen, 1 Kühlen, 2 Beides).
 *        Kühlgerät (Kühlschrank oder Pumpe/Ventil) wird wie die Heizung per
 *        433 MHz oder REST geschaltet, mit eigenen Codes/URLs, per Hysterese
 *        und Mindest-Lauf-/Pausenzeit (Kompressorschutz).
 *        Rezept-JSON-Puffer auf 8 KB (16 Rasten mit Info passten nicht in 4 KB).
 *
 * 4.2.0: ThingSpeak-Upload (Einstellungen → ThingSpeak), config.json-Puffer
 *        vergrößert (StaticJsonDocument<512>/<256> war für alle Keys zu klein)
 *
 * ThingSpeak Feldbelegung:
 *   field1 Ist-Temp °C   field2 Soll-Temp °C   field3 PID %      field4 Aktor 0 aus/1 Heizen/2 Kühlen
 *   field5 Rast-Nr       field6 Zustand 0..3   field7 Gradient   field8 Sensorfehler 0/1
 *
 * API-Version 2 (index.html prüft "api" im Status):
 *   - BML wird im Browser geparst → POST /api/rezept (JSON)
 *   - Rasten-Liste nicht mehr im Status, sondern GET /api/rezept
 *   - Log-Chart liest /api/log/download (CSV) direkt
 *
 * Reset:
 *   - Flash-Knopf (D3) beim Start gedrückt halten → löscht WLAN-Config
 *   - ESP startet dann im AP-Modus: SSID "BrewBrick" (offen)
 */

#include <ESP8266WiFi.h>
#include <ESP8266WebServer.h>
#include <ESP8266mDNS.h>
#include <LittleFS.h>
#include <OneWire.h>
#include <DallasTemperature.h>
#include <PID_v1.h>
#include <RCSwitch.h>
#include <ArduinoJson.h>
#include <ESP8266HTTPUpdateServer.h>  // OTA Firmware Update
#include <ESP8266HTTPClient.h>        // REST-Steckdosen (Shelly etc.)

// ── PINS ────────────────────────────────────────────────────
#define PIN_DS18B20   4   // D2
#define PIN_BUZZER    0   // D3
#define PIN_RCSWITCH  15  // D8
#define PIN_LED        2  // D4 — onboard LED (active-low)

// ── WLAN ────────────────────────────────────────────────────
// Credentials werden aus wlan.json geladen (LittleFS)
// Hardcoded nur Fallback-Hostname
const char* HOSTNAME = "brewbrick";

// WLAN-Modus
bool apModus = false;  // true = Access Point für WLAN-Einrichtung

// AP HTML (minimal, kein PROGMEM nötig da nur temporär)
const char AP_HTML[] PROGMEM =
  "<!DOCTYPE html><html lang=\"de\"><head>"
  "<meta charset=\"UTF-8\">"
  "<meta name=\"viewport\" content=\"width=device-width,initial-scale=1\">"
  "<title>Brausteuerung WLAN</title>"
  "<style>"
  "body{font-family:monospace;background:#0F1410;color:#C8DCC8;padding:24px;max-width:400px;margin:0 auto}"
  "h2{color:#7DDB9A;font-size:1.4rem;margin-bottom:20px}"
  "label{font-size:0.75rem;color:#5A7A5E;text-transform:uppercase;letter-spacing:0.1em;display:block;margin-bottom:4px}"
  "input,select{width:100%;background:#1C2620;border:1px solid #2A3D2E;color:#E8F4E8;padding:10px;margin-bottom:16px;border-radius:2px;font-family:monospace;font-size:0.9rem}"
  "button{background:#4CAF6E;color:#0F1410;border:none;padding:12px 24px;width:100%;font-weight:bold;font-size:0.9rem;cursor:pointer;border-radius:2px;letter-spacing:0.1em}"
  "button:hover{background:#7DDB9A}"
  ".hint{font-size:0.72rem;color:#5A7A5E;margin-bottom:20px;line-height:1.6}"
  ".net{padding:8px;border:1px solid #2A3D2E;margin-bottom:6px;cursor:pointer;border-radius:2px}"
  ".net:hover{border-color:#4CAF6E;color:#7DDB9A}"
  ".rssi{float:right;color:#5A7A5E}"
  "#status{margin-top:16px;color:#D4882A;font-size:0.8rem;min-height:20px}"
  "</style></head><body>"
  "<h2>🍺 WLAN Einrichtung</h2>"
  "<p class=\"hint\">Wähle dein WLAN-Netz oder gib die SSID manuell ein.<br>Erreichbar unter: <b style=\"color:#7DDB9A\">http://brewbrick.local</b></p>"
  "<div id=\"nets\"><p style=\"color:#5A7A5E\">Suche Netzwerke...</p></div>"
  "<br>"
  "<label>SSID</label>"
  "<input type=\"text\" id=\"ssid\" placeholder=\"WLAN-Name\">"
  "<label>Passwort</label>"
  "<input type=\"password\" id=\"pw\" placeholder=\"Passwort\">"
  "<button onclick=\"speichern()\">Verbinden &amp; Speichern</button>"
  "<div id=\"status\"></div>"
  "<script>"
  "fetch('/ap/scan').then(r=>r.json()).then(d=>{"
  "  const div=document.getElementById('nets');"
  "  if(!d.length){div.innerHTML='<p style=\"color:#5A7A5E\">Keine Netzwerke gefunden</p>';return;}"
  "  div.innerHTML=d.map(n=>"
  "    '<div class=\"net\" onclick=\"document.getElementById(\\x27ssid\\x27).value=\\x27'+n.ssid+'\\x27\">'"
  "    +n.ssid+'<span class=\"rssi\">'+n.rssi+' dBm</span></div>'"
  "  ).join('');"
  "});"
  "function speichern(){"
  "  const ssid=document.getElementById('ssid').value.trim();"
  "  const pw=document.getElementById('pw').value;"
  "  if(!ssid){document.getElementById('status').textContent='Bitte SSID eingeben';return;}"
  "  document.getElementById('status').textContent='Speichere...';"
  "  fetch('/ap/save',{method:'POST',headers:{'Content-Type':'application/json'},"
  "    body:JSON.stringify({ssid,pw})})"
  "  .then(r=>r.json()).then(d=>{"
  "    document.getElementById('status').textContent='✓ Gespeichert — Neustart...';"
  "    setTimeout(()=>location.href='http://brewbrick.local',4000);"
  "  }).catch(()=>document.getElementById('status').textContent='Fehler');"
  "}"
  "</script></body></html>";

// ── SETUP SEITE (PROGMEM) ────────────────────────────────────
// Wird angezeigt wenn keine index.html in LittleFS vorhanden ist
const char SETUP_HTML[] PROGMEM =
  "<!DOCTYPE html><html lang=\"de\"><head>"
  "<meta charset=\"UTF-8\">"
  "<meta name=\"viewport\" content=\"width=device-width,initial-scale=1\">"
  "<title>Brausteuerung Setup</title>"
  "<style>"
  "body{font-family:monospace;background:#0F1410;color:#C8DCC8;padding:32px 24px;max-width:420px;margin:0 auto;text-align:center}"
  "h1{color:#7DDB9A;font-size:1.6rem;margin-bottom:8px;letter-spacing:0.08em}"
  ".sub{color:#5A7A5E;font-size:0.75rem;margin-bottom:40px;letter-spacing:0.05em}"
  ".box{background:#161D17;border:1px solid #2A3D2E;border-radius:3px;padding:28px 24px;margin-bottom:16px}"
  "h2{color:#4CAF6E;font-size:0.85rem;text-transform:uppercase;letter-spacing:0.12em;margin-bottom:12px}"
  "p{font-size:0.78rem;color:#5A7A5E;line-height:1.7;margin-bottom:16px}"
  "b{color:#D4882A}"
  "input[type=file]{width:100%;background:#1C2620;border:1px solid #2A3D2E;color:#C8DCC8;"
  "padding:10px;border-radius:2px;font-family:monospace;font-size:0.78rem;margin-bottom:12px}"
  ".btn{width:100%;background:#4CAF6E;color:#0F1410;border:none;padding:13px;"
  "font-family:monospace;font-size:0.85rem;font-weight:bold;border-radius:2px;"
  "cursor:pointer;letter-spacing:0.08em}"
  ".btn:hover{background:#7DDB9A}"
  ".status{margin-top:12px;font-size:0.78rem;min-height:20px;color:#5A7A5E}"
  ".status.ok{color:#7DDB9A}"
  ".status.err{color:#C0504A}"
  "</style></head><body>"
  "<h1>&#x1F37A; BREWBRICK</h1>"
  "<div class=\"sub\">Ersteinrichtung</div>"
  "<div class=\"box\">"
  "<h2>&#x2B06; index.html hochladen</h2>"
  "<p>Die Web-Oberfl&auml;che muss einmalig hochgeladen werden.<br>"
  "W&auml;hle die <b>index.html</b> Datei und klicke auf Hochladen.</p>"
  "<input type=\"file\" id=\"f\" accept=\".html\">"
  "<button class=\"btn\" onclick=\"upload()\">&#x2B06; Hochladen &amp; Starten</button>"
  "<div class=\"status\" id=\"st\"></div>"
  "</div>"
  "<script>"
  "async function upload(){"
  "const file=document.getElementById('f').files[0];"
  "if(!file){document.getElementById('st').textContent='Bitte Datei w\u00e4hlen';return;}"
  "const st=document.getElementById('st');"
  "st.className='status';st.textContent='\u23f3 Lade hoch...';"
  "const form=new FormData();form.append('file',file);"
  "try{"
  "const r=await fetch('/upload/html',{method:'POST',body:form});"
  "const j=await r.json();"
  "if(j.ok){st.className='status ok';"
  "st.textContent='\u2713 Erfolgreich! Seite wird neu geladen...';"
  "setTimeout(()=>location.reload(),1500);}"
  "else{st.className='status err';st.textContent='\u2717 '+(j.error||'Fehler');}"
  "}catch(e){st.className='status err';st.textContent='\u2717 Verbindungsfehler';}"
  "}"
  "</script></body></html>";


// ── TOOLS SEITE (PROGMEM) ────────────────────────────────────
// Erreichbar unter /tools — HTML + Firmware Upload ohne Haupt-UI
const char TOOLS_HTML[] PROGMEM =
  "<!DOCTYPE html><html lang=\"de\"><head>"
  "<meta charset=\"UTF-8\">"
  "<meta name=\"viewport\" content=\"width=device-width,initial-scale=1\">"
  "<title>Brausteuerung Tools</title>"
  "<style>"
  "body{font-family:'IBM Plex Mono',monospace;background:#0F1410;color:#C8DCC8;padding:24px;max-width:500px;margin:0 auto}"
  "h1{color:#7DDB9A;font-size:1.4rem;margin-bottom:4px;letter-spacing:0.08em}"
  ".sub{color:#5A7A5E;font-size:0.72rem;margin-bottom:32px;letter-spacing:0.05em}"
  "h2{color:#4CAF6E;font-size:0.85rem;text-transform:uppercase;letter-spacing:0.12em;"
  "border-bottom:1px solid #2A3D2E;padding-bottom:8px;margin:24px 0 12px}"
  "p{font-size:0.78rem;color:#5A7A5E;line-height:1.7;margin-bottom:12px}"
  "b{color:#D4882A}"
  ".row{display:flex;gap:10px;align-items:center;flex-wrap:wrap;margin-bottom:8px}"
  "input[type=file]{background:#1C2620;border:1px solid #2A3D2E;color:#C8DCC8;"
  "padding:8px;border-radius:2px;font-family:monospace;font-size:0.78rem;flex:1}"
  ".btn{font-family:'IBM Plex Mono',monospace;font-size:0.75rem;font-weight:600;"
  "letter-spacing:0.08em;text-transform:uppercase;border:none;border-radius:2px;"
  "padding:10px 18px;cursor:pointer;transition:all 0.15s;white-space:nowrap}"
  ".btn-green{background:#4CAF6E;color:#0F1410}"
  ".btn-green:hover{background:#7DDB9A}"
  ".btn-amber{background:#7A4E10;color:#D4882A;border:1px solid #7A4E10}"
  ".btn-amber:hover{background:#D4882A;color:#0F1410}"
  ".btn-ghost{background:transparent;color:#5A7A5E;border:1px solid #2A3D2E}"
  ".btn-ghost:hover{border-color:#3D5C42;color:#C8DCC8}"
  ".status{font-size:0.75rem;margin-top:8px;min-height:18px;color:#5A7A5E}"
  ".status.ok{color:#7DDB9A}"
  ".status.err{color:#C0504A}"
  ".back{display:inline-block;margin-top:24px;font-size:0.72rem;color:#5A7A5E;"
  "text-decoration:none;border:1px solid #2A3D2E;padding:6px 14px;border-radius:2px}"
  ".back:hover{color:#C8DCC8;border-color:#3D5C42}"
  "</style></head><body>"
  "<h1>&#9881; TOOLS</h1>"
  "<div class=\"sub\">brewbrick.local/tools</div>"

  "<h2>&#x2B06; index.html aktualisieren</h2>"
  "<p>Neue Web-Oberfl&auml;che hochladen ohne USB. Wird in LittleFS gespeichert "
  "und sofort aktiv. Mit <b>Reset</b> zur&uuml;ck auf die eingebettete Version.</p>"
  "<div class=\"row\">"
  "<input type=\"file\" id=\"htmlFile\" accept=\".html\">"
  "<button class=\"btn btn-green\" onclick=\"uploadHtml()\">&#x2B06; Upload</button>"
  "<button class=\"btn btn-ghost\" onclick=\"htmlReset()\">&#x21BA; Reset</button>"
  "</div>"
  "<div class=\"status\" id=\"htmlSt\"></div>"

  "<h2>&#x26A1; Firmware OTA Update</h2>"
  "<p>Arduino IDE: <b>Sketch &rarr; Exportiere kompilierte Bin&auml;rdatei</b><br>"
  "Dann die <b>.bin</b> Datei hier hochladen. ESP startet automatisch neu.</p>"
  "<div class=\"row\">"
  "<input type=\"file\" id=\"fwFile\" accept=\".bin\">"
  "<button class=\"btn btn-amber\" onclick=\"uploadFw()\">&#x26A1; Flashen</button>"
  "</div>"
  "<div class=\"status\" id=\"fwSt\"></div>"

  "<h2>&#x1F4BE; Einstellungen Backup / Restore</h2>"
  "<p>Sichert oder stellt <b>config.json</b> wieder her (RCSwitch, PID, Einstellungen).</p>"
  "<div class=\"row\">"
  "<a href=\"/api/settings/backup\" download=\"brewbrick_config.json\" class=\"btn btn-green\">&#x2B07; Backup herunterladen</a>"
  "</div>"
  "<div class=\"section-title\" style=\"margin-top:16px\">Einstellungen wiederherstellen</div>"
  "<div class=\"row\">"
  "<input type=\"file\" id=\"cfgFile\" accept=\".json\">"
  "<button class=\"btn btn-amber\" onclick=\"restoreConfig()\">&#x2B06; Restore</button>"
  "</div>"
  "<div class=\"status\" id=\"cfgSt\"></div>"
  "<h2>&#x1F4F6; Komplett-Reset</h2>"
  "<p>L\u00f6scht <b>alle Dateien</b> im Flash (WLAN, Config, Rezept, Log, HTML) und startet neu im AP-Modus.<br>"
  "<b style=\"color:#C0504A\">Achtung: Alle Einstellungen gehen verloren!</b></p>"
  "<button class=\"btn btn-amber\" onclick=\"wlanReset()\">&#x26A0; Alles l\u00f6schen &amp; Neustart</button>"
  "<div id=\"wlanSt\" class=\"status\" style=\"margin-top:8px\"></div>"
  "<h2>&#x1F4CA; System Info</h2>"
  "<div id=\"sysinfo\" style=\"font-size:0.78rem;color:#5A7A5E;line-height:2\">Lade...</div>"

  "<a href=\"/\" class=\"back\">&#x2190; Zur&uuml;ck zur Steuerung</a>"

  "<script>"
  "async function uploadHtml(){"
  "const f=document.getElementById('htmlFile').files[0];"
  "if(!f)return;"
  "const st=document.getElementById('htmlSt');"
  "st.className='status';st.textContent='⏳ Lade hoch...';"
  "const form=new FormData();form.append('file',f);"
  "try{"
  "const r=await fetch('/upload/html',{method:'POST',body:form});"
  "const j=await r.json();"
  "if(j.ok){st.className='status ok';st.textContent='✓ '+j.msg;}"
  "else{st.className='status err';st.textContent='✗ '+(j.error||'Fehler');}"
  "}catch(e){st.className='status err';st.textContent='✗ Verbindungsfehler';}"
  "}"
  "async function htmlReset(){"
  "const r=await fetch('/upload/html-reset');"
  "const j=await r.json();"
  "const st=document.getElementById('htmlSt');"
  "st.className='status ok';st.textContent='✓ '+j.msg;"
  "}"
  "async function uploadFw(){"
  "const f=document.getElementById('fwFile').files[0];"
  "if(!f)return;"
  "const st=document.getElementById('fwSt');"
  "st.className='status';st.textContent='⏳ Flashe Firmware — bitte warten...';"
  "const form=new FormData();form.append('firmware',f);"
  "try{"
  "const r=await fetch('/update',{method:'POST',body:form,"
  "headers:{'Authorization':'Basic '+btoa('admin:brau2024')}});"
  "if(r.ok){st.className='status ok';st.textContent='✓ Update erfolgreich — ESP startet neu...';}"
  "else{st.className='status err';st.textContent='✗ Update fehlgeschlagen ('+r.status+')';}"
  "}catch(e){"
  "st.className='status ok';st.textContent='✓ ESP startet neu — bitte warten...';"
  "setTimeout(()=>location.href='/',5000);"
  "}"
  "}"
  "async function restoreConfig(){"
  "const f=document.getElementById('cfgFile').files[0];"
  "if(!f)return;"
  "const st=document.getElementById('cfgSt');"
  "st.className='status';st.textContent='⏳ Wiederherstelle...';"
  "const form=new FormData();form.append('file',f);"
  "try{"
  "const r=await fetch('/upload/config',{method:'POST',body:form});"
  "const j=await r.json();"
  "if(j.ok){st.className='status ok';st.textContent='✓ Wiederhergestellt — neu laden';}"
  "else{st.className='status err';st.textContent='✗ Fehler';}"
  "}catch(e){st.className='status err';st.textContent='✗ Verbindungsfehler';}"
  "}"
  "async function wlanReset(){"
  "if(!confirm('WLAN-Config wirklich loeschen?')) return;"
  "const st=document.getElementById('wlanSt');"
  "st.textContent='Losche...';"
  "try{ await fetch('/api/wlan/reset',{method:'POST'}); }catch(e){}"
  "st.textContent='ESP startet neu...';"
  "}"
  "async function ladeSysinfo(){"
  "try{"
  "const r=await fetch('/api/sysinfo');const d=await r.json();"
  "document.getElementById('sysinfo').innerHTML="
  "'IP: <b style=\"color:#7DDB9A\">'+d.ip+'</b> &nbsp; <a href=\"http://'+d.ip+'\" style=\"color:#2D6640;font-size:0.65rem\">öffnen</a><br>'"
  "+('Hostname: <b>'+d.hostname+'.local</b><br>')"
  "+('Heap frei: <b style=\"color:#7DDB9A\">'+( d.freeHeap/1024).toFixed(1)+' KB</b><br>')"
  "+'LittleFS: <b>'+d.fsUsed+' / '+d.fsTotal+' B</b><br>'"
  "+'Sketch: <b>'+(d.sketchSize/1024).toFixed(0)+' KB (frei: '+(d.freeSketch/1024).toFixed(0)+' KB)</b><br>'"
  "+'Uptime: <b>'+Math.floor(d.uptime/60)+' min</b><br>'"
  "+'HTML: <b style=\"color:#D4882A\">'+( d.htmlLittleFS?'LittleFS':'PROGMEM')+' </b>';"
  "}catch(e){document.getElementById('sysinfo').textContent='Fehler beim Laden';}"
  "}"
  "ladeSysinfo();"
  "</script></body></html>";

// ── HARDWARE ────────────────────────────────────────────────
OneWire           oneWire(PIN_DS18B20);
DallasTemperature sensors(&oneWire);
RCSwitch          rcSwitch;
ESP8266WebServer      server(80);
ESP8266HTTPUpdateServer otaServer;  // OTA Firmware Update

// OTA läuft gerade?
bool otaLaeuft = false;

// ── PID ─────────────────────────────────────────────────────
double pidInput    = 20.0;
double pidOutput   = 0.0;
double pidSetpoint = 67.0;
double Kp = 5.0, Ki = 0.05, Kd = 10.0;
double pidSchwellwert    = 5.0;  // °C unter Soll → 100% Leistung
double pidUeberschreitung = 0.5;  // °C über Soll → Notabschaltung
PID myPID(&pidInput, &pidOutput, &pidSetpoint, Kp, Ki, Kd, DIRECT);

unsigned long PID_WINDOW_MS = 30000;  // konfigurierbar über Web-UI (in ms)
unsigned int  pidSampleMs   = 2000;   // PID-Rechentakt, konfigurierbar (100..30000 ms)
unsigned long pidWindowStart = 0;

// ── RCSWITCH ─────────────────────────────────────────────────
unsigned long rcCodeOn         = 1631343;
unsigned long rcCodeOff        = 1631342;
unsigned int  rcProtocol       = 1;
unsigned int  rcPulse          = 315;
unsigned int  rcBits           = 24;
unsigned int  rcWiederholungen = 15;
bool          heizungAn        = false;
unsigned long letztesSenden    = 0;        // Zeitstempel letztes RC-Signal
unsigned long RC_REPEAT_MS     = 10000;  // Wiederholungsintervall in ms
unsigned long RC_MIN_SCHALT_MS = 200;    // Mindest-Schaltzeit in ms (Relais-Schutz)

// ── KÜHLUNG ──────────────────────────────────────────────────
// Schaltet über denselben Weg wie die Heizung (schaltModus), aber mit
// eigenen RC-Codes bzw. einem eigenen REST-URL-Paar. Geregelt wird per
// Hysterese: EIN über Soll + kuehlHyst, AUS bei Erreichen von Soll.
unsigned long kRcOn  = 0;
unsigned long kRcOff = 0;
char          kUrlOn[128]  = "";
char          kUrlOff[128] = "";
int           kuehlTyp      = 0;         // 0 Kühlschrank, 1 Pumpe/Ventil (nur Vorgabe in der UI)
float         kuehlHyst     = 0.5f;      // °C über Soll → Kühlung EIN
unsigned long kuehlMinAnMs  = 120000UL;  // Mindestlaufzeit
unsigned long kuehlMinAusMs = 300000UL;  // Mindestpause (Kompressorschutz)
bool          kuehlungAn    = false;
bool          kuehlGeschaltet = false;   // schon einmal geschaltet? (vorher keine Sperrzeit)
unsigned long kuehlLetzterWechsel = 0;
unsigned long kuehlLetztesSenden  = 0;

// ── SCHALT-MODUS & REST-STECKDOSEN ───────────────────────────
#define MAX_REST 6
int  schaltModus  = 0;   // 0 = RC433 Funk, 1 = REST-Steckdose
bool restEnabled[MAX_REST] = {true, false, false, false, false, false};
bool restStrikt200 = false;  // true = nur HTTP 200 gilt als Erfolg
struct RestDose {
  char name[24];
  char urlOn[128];
  char urlOff[128];
};
RestDose restDosen[MAX_REST];

// ── RASTEN ───────────────────────────────────────────────────
#define MAX_RASTEN 16

struct Rast {
  char  name[32];
  bool  on, halt, call;
  bool  ownPid;          // true = eigene PID-Werte verwenden
  float sollTemp;
  float time;   // Minuten, auch Dezimalwerte z.B. 0.5 = 30s
  float minTemp, maxTemp;
  float kp, ki, kd;
  float maxGradient;
  uint8_t modus;         // 0 = Heizen, 1 = Kühlen, 2 = Heizen + Kühlen
  char  info[128];
};

Rast  rasten[MAX_RASTEN];
int   rastAnzahl   = 0;
uint16_t rezeptVersion = 1;   // wird bei jeder Rezeptänderung erhöht → Browser lädt neu
#define API_VERSION 2
#define FW_VERSION "4.3.0"
int   aktiveRast   = -1;
bool  wartendHalt  = false;

unsigned long rastStartMs = 0;
unsigned long rastDauerMs = 0;

// ── ZUSTAND ──────────────────────────────────────────────────
enum Zustand { GESTOPPT, AUFHEIZEN, RAST_LAEUFT, WARTEN_HALT };
Zustand zustand = GESTOPPT;
int8_t  rastRichtung = 1;   // +1 = auf Soll aufheizen, -1 = auf Soll abkühlen

// ── TEMPERATURSENSOR ─────────────────────────────────────────
float tempAktuell = 0.0;
float tempGradient = 0.0;          // °C/min
uint8_t sensorFehlerZaehler = 0;   // Zählt aufeinanderfolgende Fehlmessungen
bool    sensorFehler = false;       // true = Sensor getrennt
unsigned long letztesTempRead = 0;
const unsigned long TEMP_INTERVAL = 2000;

// ── FLASH LOG ────────────────────────────────────────────────
// Mindestabstand und Temperaturschwelle sind konfigurierbar (config.json:
// logIntervall in s, logDelta in °C) — für Sprungantwort-Messungen z.B. 5 s / 0.1 °C.
unsigned long logIntervallMs  = 10000UL;  // ms: Mindest-Abstand zwischen Punkten (2..600 s)
float         logDeltaC       = 0.5f;     // °C: Schwellwert für Speicherung (0.05..5)
#define LOG_MAX_INTERVAL 60000UL   // ms: Spätestens alle 60s loggen
#define LOG_RAST_CHANGE  true      // bei Rast-Wechsel immer loggen
unsigned long logStartMs   = 0;
unsigned long letzterLogMs    = 0;
bool          logAktiv        = false;
float         letzteLogTemp   = -999.0f;  // letzter gelogter Temperaturwert
int           letzteLogRast   = -1;       // letzte gelogte Rast  // nur wenn Brauvorgang läuft

// ── LED STATUS ───────────────────────────────────────────────
unsigned long ledLetzteAktion = 0;
int           ledPhase        = 0;

void ledUpdate() {
  unsigned long jetzt = millis();
  if (sensorFehler) {
    // Sensor-Fehler: sehr schnell blinken (100ms)
    if (jetzt - ledLetzteAktion >= 100) {
      ledPhase = !ledPhase;
      digitalWrite(PIN_LED, ledPhase ? LOW : HIGH);
      ledLetzteAktion = jetzt;
    }
  } else if (apModus) {
    // AP-Modus: langsam blinken (1s)
    if (jetzt - ledLetzteAktion >= 1000) {
      ledPhase = !ledPhase;
      digitalWrite(PIN_LED, ledPhase ? LOW : HIGH);
      ledLetzteAktion = jetzt;
    }
  } else {
    // Bereit: kurzes Blinken alle 3s
    unsigned long t = jetzt % 3000;
    if (t < 80) digitalWrite(PIN_LED, LOW);   // kurz an
    else        digitalWrite(PIN_LED, HIGH);   // meist aus
  }
}
bool          callMuted    = false;  // true = Piepen für diese Rast stumm
unsigned long letzterCallPiep = 0;  // Zeitstempel letztes Call-Piepen

void logReset() {
  logAktiv      = false;
  logStartMs    = 0;
  letzterLogMs  = 0;
  letzteLogTemp = -999.0f;
  letzteLogRast = -1;
  LittleFS.remove("/log.csv");
  Serial.println("[LOG] Flash-Log gelöscht und zurückgesetzt");
}

void logStart() {
  logReset();
  logAktiv = true;
  File f = LittleFS.open("/log.csv", "w");
  if (f) { f.println("Zeit_s;Temp_C;Soll_C;PID_Pct;Rast;Kuehl"); f.close(); }
  Serial.println("[LOG] Flash-Log gestartet");
}

void logPunkt() {
  if (!logAktiv) return;
  unsigned long jetzt = millis();
  // Mindestabstand zwischen Punkten
  if (jetzt - letzterLogMs < logIntervallMs) return;
  // Speichern wenn:
  //   - Temperatur sich um mindestens logDeltaC geändert hat
  //   - Rast gewechselt hat
  //   - Spätestens nach LOG_MAX_INTERVAL
  bool aenderung = fabs(tempAktuell - letzteLogTemp) >= logDeltaC;
  bool rastWechsel = (aktiveRast != letzteLogRast);
  bool timeout = (jetzt - letzterLogMs >= LOG_MAX_INTERVAL);
  if (!aenderung && !rastWechsel && !timeout) return;
  letzterLogMs  = jetzt;
  letzteLogTemp = tempAktuell;
  letzteLogRast = aktiveRast;
  unsigned long sek = (jetzt - logStartMs) / 1000UL;
  File f = LittleFS.open("/log.csv", "a");
  if (f) {
    f.printf("%lu;%.2f;%.2f;%u;%d;%d\n",
      sek, tempAktuell, pidSetpoint,
      (uint8_t)constrain(pidOutput, 0, 100),
      aktiveRast, kuehlungAn ? 1 : 0);
    f.close();
  }
}

// ── BUZZER ───────────────────────────────────────────────────
void buzzerRuf(int n = 3) {
  for (int i = 0; i < n; i++) {
    digitalWrite(PIN_BUZZER, HIGH); delay(80);
    digitalWrite(PIN_BUZZER, LOW);  delay(120);
    yield();
  }
}

// ── HEIZUNG ──────────────────────────────────────────────────
void rcSend(unsigned long code) {
  rcSwitch.setRepeatTransmit(rcWiederholungen);
  rcSwitch.send(code, rcBits);
}

// REST-URL aufrufen (non-blocking-ish, kurzes Timeout)
bool restCall(const char* url) {
  if (!url || strlen(url) < 8) return false;  // leere URL
  if (WiFi.status() != WL_CONNECTED) return false;
  WiFiClient client;
  HTTPClient http;
  http.setTimeout(2000);  // 2s Timeout — nicht zu lange blockieren
  if (!http.begin(client, url)) return false;
  int code = http.GET();
  http.end();
  yield();
  // Erfolg: entweder nur 200 (strikt) oder alle 2xx/3xx (generisch)
  bool erfolg = restStrikt200 ? (code == 200) : (code > 0 && code < 400);
  if (erfolg) {
    Serial.printf("[REST] %s → HTTP %d OK\n", url, code);
    return true;
  }
  Serial.printf("[REST] FEHLER %s → HTTP %d\n", url, code);
  return false;
}

// Schaltet EIN — je nach Modus RC433 oder alle aktiven REST-Dosen
void schalteEin() {
  if (schaltModus == 1) {
    for (int i = 0; i < MAX_REST; i++) {
      if (restEnabled[i]) restCall(restDosen[i].urlOn);
    }
  } else {
    rcSend(rcCodeOn);
  }
}

// Schaltet AUS — je nach Modus RC433 oder alle aktiven REST-Dosen
void schalteAus() {
  if (schaltModus == 1) {
    for (int i = 0; i < MAX_REST; i++) {
      if (restEnabled[i]) restCall(restDosen[i].urlOff);
    }
  } else {
    rcSend(rcCodeOff);
  }
}

void heizungEin() {
  unsigned long jetzt = millis();
  bool zustandsWechsel = !heizungAn;
  bool wiederholung    = (jetzt - letztesSenden >= RC_REPEAT_MS);
  // Relais-Schutz: nicht schalten wenn letzte Schaltung zu kurz her
  if (zustandsWechsel && (jetzt - letztesSenden < RC_MIN_SCHALT_MS)) return;
  if (zustandsWechsel || wiederholung) {
    schalteEin();
    heizungAn    = true;
    letztesSenden = jetzt;
  }
}
void heizungAus() {
  unsigned long jetzt = millis();
  bool zustandsWechsel = heizungAn;
  bool wiederholung    = (jetzt - letztesSenden >= RC_REPEAT_MS);
  // Relais-Schutz: nicht schalten wenn letzte Schaltung zu kurz her
  if (zustandsWechsel && (jetzt - letztesSenden < RC_MIN_SCHALT_MS)) return;
  if (zustandsWechsel || wiederholung) {
    schalteAus();
    heizungAn    = false;
    letztesSenden = jetzt;
  }
}

// ── KÜHLUNG SCHALTEN ─────────────────────────────────────────
void kuehlSenden(bool an) {
  if (schaltModus == 1) {
    restCall(an ? kUrlOn : kUrlOff);
  } else {
    unsigned long code = an ? kRcOn : kRcOff;
    if (code) rcSend(code);   // nicht konfiguriert → nichts senden
  }
}

// Setzt den Kühlzustand unter Beachtung von Mindestlauf-/Pausenzeit.
// erzwingen = Stopp, Sensorfehler, Test — ignoriert die Sperrzeiten.
// Wiederholt das aktuelle Signal alle RC_REPEAT_MS (wie bei der Heizung).
void kuehlungSetzen(bool an, bool erzwingen = false) {
  unsigned long jetzt = millis();
  if (an != kuehlungAn) {
    if (!erzwingen && kuehlGeschaltet) {
      unsigned long seit = jetzt - kuehlLetzterWechsel;
      if (an  && seit < kuehlMinAusMs) return;   // Kompressor braucht Pause
      if (!an && seit < kuehlMinAnMs)  return;   // Mindestlaufzeit
    }
    kuehlSenden(an);
    kuehlungAn          = an;
    kuehlGeschaltet     = true;
    kuehlLetzterWechsel = jetzt;
    kuehlLetztesSenden  = jetzt;
    Serial.printf("[KUEHL] %s bei %.2f°C (Soll %.2f)\n", an ? "EIN" : "AUS", tempAktuell, pidSetpoint);
    return;
  }
  if (jetzt - kuehlLetztesSenden >= RC_REPEAT_MS) {
    kuehlSenden(an);
    kuehlLetztesSenden = jetzt;
  }
}

// ── THINGSPEAK ───────────────────────────────────────────────
// Upload per HTTP (nicht HTTPS) — spart ~20 KB Heap für BearSSL.
// Free-Account: min. 15 s zwischen zwei Updates pro Kanal.
bool          tsAktiv        = false;
char          tsKey[24]      = "";        // Write API Key (16 Zeichen)
unsigned long tsChannel      = 0;         // nur für den Link in der Web-UI
unsigned long tsIntervallMs  = 30000UL;   // 15..3600 s
bool          tsNurBrauen    = true;      // nur senden während ein Rezept läuft
unsigned long tsLetzterVersuch = 0;
unsigned long tsLetzterErfolg  = 0;
long          tsLetzteEntry    = -1;      // Entry-ID der letzten erfolgreichen Übertragung
uint16_t      tsFehler         = 0;       // Fehler in Folge
char          tsStatus[64]     = "noch nicht gesendet";

// Nur A-Z / 0-9 übernehmen — Key landet ungeschützt in der URL
void tsKeySetzen(const char* k) {
  size_t j = 0;
  for (size_t i = 0; k && k[i] && j < sizeof(tsKey) - 1; i++) {
    char c = k[i];
    if (c >= 'a' && c <= 'z') c -= 32;
    if ((c >= 'A' && c <= 'Z') || (c >= '0' && c <= '9')) tsKey[j++] = c;
  }
  tsKey[j] = 0;
}

// Sendet einen Datensatz. erzwingen = Test-Button (ignoriert Intervall/nurBrauen).
bool thingSpeakSenden(bool erzwingen = false) {
  if (apModus) return false;
  if (!erzwingen) {
    if (!tsAktiv || strlen(tsKey) < 8) return false;
    if (tsNurBrauen && zustand == GESTOPPT) return false;
    if (tsLetzterVersuch != 0 && millis() - tsLetzterVersuch < tsIntervallMs) return false;
  }
  tsLetzterVersuch = millis();
  if (strlen(tsKey) < 8) { strlcpy(tsStatus, "kein gültiger Write API Key", sizeof(tsStatus)); return false; }
  if (WiFi.status() != WL_CONNECTED) {
    tsFehler++; strlcpy(tsStatus, "kein WLAN", sizeof(tsStatus)); return false;
  }
  char url[320];
  int n = snprintf(url, sizeof(url),
    "http://api.thingspeak.com/update?api_key=%s&field2=%.1f&field3=%.0f&field4=%d&field5=%d&field6=%d&field8=%d",
    tsKey, pidSetpoint, constrain(pidOutput, 0.0, 100.0), (heizungAn ? 1 : 0) | (kuehlungAn ? 2 : 0),
    aktiveRast, (int)zustand, sensorFehler ? 1 : 0);
  // Bei Sensorfehler Temperatur weglassen → Lücke im Chart statt veraltetem Wert
  if (!sensorFehler && n > 0 && n < (int)sizeof(url))
    snprintf(url + n, sizeof(url) - n, "&field1=%.2f&field7=%.2f", tempAktuell, tempGradient);

  WiFiClient client;
  HTTPClient http;
  http.setTimeout(3000);
  bool ok = false;
  if (http.begin(client, url)) {
    int code = http.GET();
    if (code == 200) {
      long entry = http.getString().toInt();
      if (entry > 0) {
        ok = true;
        tsLetzteEntry = entry;
        tsLetzterErfolg = millis();
        snprintf(tsStatus, sizeof(tsStatus), "OK — Eintrag %ld", entry);
      } else {
        // ThingSpeak antwortet mit "0": falscher Key oder schneller als 15 s
        strlcpy(tsStatus, "abgelehnt (0) — Key falsch oder < 15 s seit letztem Update", sizeof(tsStatus));
      }
    } else {
      snprintf(tsStatus, sizeof(tsStatus), "HTTP-Fehler %d", code);
    }
    http.end();
  } else {
    strlcpy(tsStatus, "Verbindung fehlgeschlagen", sizeof(tsStatus));
  }
  tsFehler = ok ? 0 : tsFehler + 1;
  Serial.printf("[TS] %s\n", tsStatus);
  yield();
  return ok;
}

// ── REST-STECKDOSEN ──────────────────────────────────────────
void restDosenLaden() {
  // Defaults
  for (int i = 0; i < MAX_REST; i++) {
    snprintf(restDosen[i].name, sizeof(restDosen[i].name), "Steckdose %d", i+1);
    restDosen[i].urlOn[0]  = 0;
    restDosen[i].urlOff[0] = 0;
  }
  File f = LittleFS.open("/rest.json", "r");
  if (!f) return;
  DynamicJsonDocument doc(3072);
  if (deserializeJson(doc, f) == DeserializationError::Ok) {
    JsonArray arr = doc["dosen"];
    int i = 0;
    for (JsonObject o : arr) {
      if (i >= MAX_REST) break;
      strlcpy(restDosen[i].name,   o["name"]   | "", sizeof(restDosen[i].name));
      strlcpy(restDosen[i].urlOn,  o["urlOn"]  | "", sizeof(restDosen[i].urlOn));
      strlcpy(restDosen[i].urlOff, o["urlOff"] | "", sizeof(restDosen[i].urlOff));
      i++;
    }
  }
  f.close();
  Serial.println("[REST] Steckdosen geladen");
}

void restDosenSpeichern(const String& body) {
  DynamicJsonDocument doc(3072);
  if (deserializeJson(doc, body) != DeserializationError::Ok) return;
  JsonArray arr = doc["dosen"];
  int i = 0;
  for (JsonObject o : arr) {
    if (i >= MAX_REST) break;
    strlcpy(restDosen[i].name,   o["name"]   | "", sizeof(restDosen[i].name));
    strlcpy(restDosen[i].urlOn,  o["urlOn"]  | "", sizeof(restDosen[i].urlOn));
    strlcpy(restDosen[i].urlOff, o["urlOff"] | "", sizeof(restDosen[i].urlOff));
    i++;
  }
  // Restliche Slots leeren (falls Dosen entfernt wurden)
  for (; i < MAX_REST; i++) {
    snprintf(restDosen[i].name, sizeof(restDosen[i].name), "Steckdose %d", i+1);
    restDosen[i].urlOn[0]  = 0;
    restDosen[i].urlOff[0] = 0;
    restEnabled[i] = false;
  }
  File f = LittleFS.open("/rest.json", "w");
  if (f) { serializeJson(doc, f); f.close(); }
  Serial.println("[REST] Steckdosen gespeichert");
}

// ── CONFIG ───────────────────────────────────────────────────
void configLaden() {
  File f = LittleFS.open("/config.json", "r");
  if (!f) return;
  DynamicJsonDocument doc(2048);
  if (deserializeJson(doc, f) == DeserializationError::Ok) {
    rcCodeOn         = doc["rcOn"]    | 0UL;
    rcCodeOff        = doc["rcOff"]   | 0UL;
    rcProtocol       = doc["rcProto"] | 1;
    rcPulse          = doc["rcPulse"] | 189;
    rcBits           = doc["rcBits"]  | 24;
    rcWiederholungen = doc["rcWdh"]   | 10;
    Kp               = doc["Kp"]        | 2.0;
    Ki               = doc["Ki"]        | 0.5;
    Kd               = doc["Kd"]        | 1.0;
    PID_WINDOW_MS      = (doc["pidFenster"]   | 30)  * 1000UL;
    pidSampleMs        = constrain((int)(doc["pidSample"] | 2000), 100, 30000);
    logIntervallMs     = constrain((int)(doc["logIntervall"] | 10), 2, 600) * 1000UL;
    logDeltaC          = constrain((float)(doc["logDelta"] | 0.5f), 0.05f, 5.0f);
    pidSchwellwert     = doc["pidSchwelle"]   | 5.0;
    pidUeberschreitung = doc["pidUeberschreitung"] | 0.5;
    RC_REPEAT_MS       = (doc["rcRepeat"]     | 10)  * 1000UL;
    RC_MIN_SCHALT_MS   = doc["rcMinSchalt"]   | 200UL;
    schaltModus        = doc["schaltModus"]   | 0;
    restStrikt200      = doc["restStrikt200"] | false;
    for (int i = 0; i < MAX_REST; i++) {
      char key[10];
      snprintf(key, sizeof(key), "restEn%d", i);
      restEnabled[i] = doc[key] | (i == 0);
    }
    tsAktiv       = doc["tsAktiv"]   | false;
    tsKeySetzen(doc["tsKey"] | "");
    tsChannel     = doc["tsChannel"] | 0UL;
    tsIntervallMs = constrain((int)(doc["tsIntervall"] | 30), 15, 3600) * 1000UL;
    tsNurBrauen   = doc["tsNurBrauen"] | true;
    kRcOn         = doc["kRcOn"]  | 0UL;
    kRcOff        = doc["kRcOff"] | 0UL;
    strlcpy(kUrlOn,  doc["kUrlOn"]  | "", sizeof(kUrlOn));
    strlcpy(kUrlOff, doc["kUrlOff"] | "", sizeof(kUrlOff));
    kuehlTyp      = doc["kuehlTyp"]  | 0;
    kuehlHyst     = constrain((float)(doc["kuehlHyst"] | 0.5f), 0.1f, 10.0f);
    kuehlMinAnMs  = constrain((int)(doc["kuehlMinAn"]  | 120), 0, 3600) * 1000UL;
    kuehlMinAusMs = constrain((int)(doc["kuehlMinAus"] | 300), 0, 3600) * 1000UL;
  }
  f.close();
  restDosenLaden();  // REST-Steckdosen aus separater Datei
  myPID.SetTunings(Kp, Ki, Kd);
  rcSwitch.setProtocol(rcProtocol);
  rcSwitch.setPulseLength(rcPulse);
  rcSwitch.setRepeatTransmit(rcWiederholungen);
  Serial.printf("[CONFIG] Kp=%.2f Ki=%.3f Kd=%.2f rcOn=%lu rcOff=%lu bits=%d wdh=%d\n",
                Kp, Ki, Kd, rcCodeOn, rcCodeOff, rcBits, rcWiederholungen);
}

void configSpeichern(const String& body) {
  DynamicJsonDocument doc(2048);
  if (deserializeJson(doc, body) != DeserializationError::Ok) return;
  rcCodeOn         = doc["rcOn"]    | rcCodeOn;
  rcCodeOff        = doc["rcOff"]   | rcCodeOff;
  rcProtocol       = doc["rcProto"] | rcProtocol;
  rcPulse          = doc["rcPulse"] | rcPulse;
  rcBits           = doc["rcBits"]  | rcBits;
  rcWiederholungen = doc["rcWdh"]   | rcWiederholungen;
  Kp            = doc["Kp"]        | Kp;
  Ki            = doc["Ki"]        | Ki;
  Kd            = doc["Kd"]        | Kd;
  PID_WINDOW_MS    = (doc["pidFenster"]  | (int)(PID_WINDOW_MS/1000)) * 1000UL;
  pidSampleMs      = constrain((int)(doc["pidSample"] | (int)pidSampleMs), 100, 30000);
  logIntervallMs   = constrain((int)(doc["logIntervall"] | (int)(logIntervallMs/1000)), 2, 600) * 1000UL;
  logDeltaC        = constrain((float)(doc["logDelta"] | logDeltaC), 0.05f, 5.0f);
  pidSchwellwert     = doc["pidSchwelle"]        | pidSchwellwert;
  pidUeberschreitung = doc["pidUeberschreitung"] | pidUeberschreitung;
  RC_REPEAT_MS     = (doc["rcRepeat"]    | (int)(RC_REPEAT_MS/1000)) * 1000UL;
  RC_MIN_SCHALT_MS = doc["rcMinSchalt"]  | (int)RC_MIN_SCHALT_MS;
  schaltModus      = doc["schaltModus"]   | schaltModus;
  restStrikt200    = doc["restStrikt200"] | restStrikt200;
  for (int i = 0; i < MAX_REST; i++) {
    char key[10];
    snprintf(key, sizeof(key), "restEn%d", i);
    if (doc.containsKey(key)) restEnabled[i] = doc[key];
  }
  tsAktiv     = doc["tsAktiv"]     | tsAktiv;
  tsNurBrauen = doc["tsNurBrauen"] | tsNurBrauen;
  tsChannel   = doc["tsChannel"]   | tsChannel;
  tsIntervallMs = constrain((int)(doc["tsIntervall"] | (int)(tsIntervallMs/1000)), 15, 3600) * 1000UL;
  if (doc.containsKey("tsKey")) tsKeySetzen(doc["tsKey"] | "");
  // bereinigte/vollständige Werte persistieren (Browser schickt evtl. nicht alle)
  doc["tsAktiv"]     = tsAktiv;
  doc["tsKey"]       = (const char*)tsKey;
  doc["tsChannel"]   = tsChannel;
  doc["tsIntervall"] = (int)(tsIntervallMs / 1000);
  doc["tsNurBrauen"] = tsNurBrauen;
  tsLetzterVersuch = 0;   // neue Einstellungen → beim nächsten Loop sofort senden
  kRcOn    = doc["kRcOn"]    | kRcOn;
  kRcOff   = doc["kRcOff"]   | kRcOff;
  if (doc.containsKey("kUrlOn"))  strlcpy(kUrlOn,  doc["kUrlOn"]  | "", sizeof(kUrlOn));
  if (doc.containsKey("kUrlOff")) strlcpy(kUrlOff, doc["kUrlOff"] | "", sizeof(kUrlOff));
  kuehlTyp = doc["kuehlTyp"] | kuehlTyp;
  kuehlHyst     = constrain((float)(doc["kuehlHyst"] | kuehlHyst), 0.1f, 10.0f);
  kuehlMinAnMs  = constrain((int)(doc["kuehlMinAn"]  | (int)(kuehlMinAnMs/1000)),  0, 3600) * 1000UL;
  kuehlMinAusMs = constrain((int)(doc["kuehlMinAus"] | (int)(kuehlMinAusMs/1000)), 0, 3600) * 1000UL;
  doc["kRcOn"] = kRcOn;  doc["kRcOff"] = kRcOff;
  doc["kUrlOn"] = (const char*)kUrlOn;  doc["kUrlOff"] = (const char*)kUrlOff;
  doc["kuehlTyp"] = kuehlTyp;  doc["kuehlHyst"] = kuehlHyst;
  doc["kuehlMinAn"]  = (int)(kuehlMinAnMs / 1000);
  doc["kuehlMinAus"] = (int)(kuehlMinAusMs / 1000);
  myPID.SetTunings(Kp, Ki, Kd);
  myPID.SetSampleTime(pidSampleMs);
  rcSwitch.setProtocol(rcProtocol);
  rcSwitch.setPulseLength(rcPulse);
  rcSwitch.setRepeatTransmit(rcWiederholungen);
  File f = LittleFS.open("/config.json", "w");
  if (f) { serializeJson(doc, f); f.close(); }
  Serial.printf("[CONFIG] Gespeichert: Kp=%.2f Ki=%.3f Kd=%.2f\n", Kp, Ki, Kd);
}

// ── WLAN CONFIG ──────────────────────────────────────────────
String wlanSSID = "";
String wlanPassword = "";

bool wlanConfigLaden() {
  File f = LittleFS.open("/wlan.json", "r");
  if (!f) return false;
  StaticJsonDocument<256> doc;
  if (deserializeJson(doc, f) != DeserializationError::Ok) { f.close(); return false; }
  f.close();
  wlanSSID     = doc["ssid"] | "";
  wlanPassword = doc["pw"]   | "";
  return wlanSSID.length() > 0;
}

void wlanConfigSpeichern(const String& ssid, const String& pw) {
  StaticJsonDocument<256> doc;
  doc["ssid"] = ssid;
  doc["pw"]   = pw;
  File f = LittleFS.open("/wlan.json", "w");
  if (f) { serializeJson(doc, f); f.close(); }
  Serial.printf("[WLAN] Config gespeichert: %s\n", ssid.c_str());
}

void wlanConfigLoeschen() {
  LittleFS.remove("/wlan.json");
  Serial.println("[WLAN] Config gelöscht");
}

// ── AP MODUS ROUTEN ───────────────────────────────────────────
void apRoutenSetup() {
  // AP-Seite ausliefern
  server.on("/", HTTP_GET, []() {
    server.send_P(200, "text/html", AP_HTML);
  });

  // Netzwerkscan
  server.on("/ap/scan", HTTP_GET, []() {
    int n = WiFi.scanNetworks();
    String json = "[";
    for (int i = 0; i < n; i++) {
      if (i > 0) json += ",";
      json += "{\"ssid\":\"" + WiFi.SSID(i) + "\",\"rssi\":" + String(WiFi.RSSI(i)) + "}";
    }
    json += "]";
    server.send(200, "application/json", json);
  });

  // WLAN speichern + Neustart
  server.on("/ap/save", HTTP_POST, []() {
    if (!server.hasArg("plain")) {
      server.send(400, "application/json", "{\"error\":\"Kein Body\"}");
      return;
    }
    StaticJsonDocument<256> doc;
    if (deserializeJson(doc, server.arg("plain")) != DeserializationError::Ok) {
      server.send(400, "application/json", "{\"error\":\"JSON Fehler\"}");
      return;
    }
    String ssid = doc["ssid"] | "";
    String pw   = doc["pw"]   | "";
    if (ssid.length() == 0) {
      server.send(400, "application/json", "{\"error\":\"SSID leer\"}");
      return;
    }
    wlanConfigSpeichern(ssid, pw);
    server.send(200, "application/json", "{\"ok\":true}");
    delay(500);
    ESP.restart();
  });

  server.onNotFound([]() {
    // Im AP-Modus alles zur Startseite umleiten
    server.sendHeader("Location", "/");
    server.send(302, "text/plain", "");
  });
}

// ── REZEPT (JSON, vom Browser geparst) ───────────────────────
// Format: {"rasten":[{"name","halt","call","soll","time","ownPid",
//                     "kp","ki","kd","maxGradient","info"}, ...]}
bool rezeptAusJson(JsonDocument& doc) {
  JsonArray arr = doc["rasten"];
  if (arr.isNull()) return false;
  rastAnzahl = 0;
  for (JsonObject o : arr) {
    if (rastAnzahl >= MAX_RASTEN) break;
    Rast& r = rasten[rastAnzahl];
    strlcpy(r.name, o["name"] | "", sizeof(r.name));
    strlcpy(r.info, o["info"] | "", sizeof(r.info));
    r.on          = true;
    r.halt        = o["halt"]        | false;
    r.call        = o["call"]        | false;
    r.ownPid      = o["ownPid"]      | false;
    r.sollTemp    = o["soll"]        | 0.0f;
    r.time        = o["time"]        | 0.0f;
    r.minTemp     = o["minTemp"]     | 0.0f;
    r.maxTemp     = o["maxTemp"]     | 0.0f;
    r.kp          = o["kp"]          | 0.0f;
    r.ki          = o["ki"]          | 0.0f;
    r.kd          = o["kd"]          | 0.0f;
    r.maxGradient = o["maxGradient"] | 0.0f;
    r.modus       = constrain((int)(o["modus"] | 0), 0, 2);
    rastAnzahl++;
    yield();
  }
  rezeptVersion++;
  return rastAnzahl > 0;
}

bool rezeptLaden() {
  LittleFS.remove("/rezept.bml");  // Altlast aus Firmware < 4.1
  File f = LittleFS.open("/rezept.json", "r");
  if (!f) return false;
  DynamicJsonDocument doc(8192);
  bool ok = (deserializeJson(doc, f) == DeserializationError::Ok);
  f.close();
  if (!ok) { Serial.println("[REZEPT] rezept.json ungültig"); return false; }
  return rezeptAusJson(doc);
}

// Speichert den Body 1:1 als /rezept.json und übernimmt ihn in den RAM
bool rezeptSpeichern(const String& body) {
  DynamicJsonDocument doc(8192);
  if (deserializeJson(doc, body) != DeserializationError::Ok) return false;
  if (!rezeptAusJson(doc)) return false;
  File f = LittleFS.open("/rezept.json", "w");
  if (f) { serializeJson(doc, f); f.close(); }
  Serial.printf("[REZEPT] Gespeichert: %d Rasten\n", rastAnzahl);
  return true;
}

void rezeptLoeschen() {
  rastAnzahl = 0;
  aktiveRast = -1;
  zustand    = GESTOPPT;
  heizungAus();
  kuehlungSetzen(false, true);
  LittleFS.remove("/rezept.json");
  rezeptVersion++;
  Serial.println("[REZEPT] Gelöscht");
}

// ── RAST STARTEN ─────────────────────────────────────────────
void rastStarten(int nr) {
  if (nr < 0 || nr >= rastAnzahl) return;
  aktiveRast   = nr;
  wartendHalt  = false;
  zustand      = AUFHEIZEN;
  Rast& r      = rasten[nr];
  pidSetpoint  = r.sollTemp;
  rastDauerMs  = (unsigned long)(r.time * 60.0f * 1000.0f);
  // Kühlen → warten bis Soll unterschritten; Beides → Richtung nach Starttemperatur
  rastRichtung = (r.modus == 1 || (r.modus == 2 && tempAktuell > r.sollTemp)) ? -1 : 1;
  // Rast-spezifische PID-Parameter wenn ownPid gesetzt
  if (r.ownPid) myPID.SetTunings(r.kp, r.ki, r.kd);
  else          myPID.SetTunings(Kp, Ki, Kd);
  pidWindowStart = millis();
  // PID zurücksetzen
  myPID.SetMode(MANUAL);
  pidOutput = 100.0;
  myPID.SetMode(AUTOMATIC);
  myPID.SetOutputLimits(0, 100);
  callMuted = false;  // Stummschaltung für neue Rast zurücksetzen
  letzterCallPiep = 0;
  // Log nur beim ersten Rast-Start beginnen
  if (!logAktiv) logStart();
  Serial.printf("[RAST %d] %s | Soll: %.1f°C | %.1f min\n",
                nr, r.name, r.sollTemp, r.time);
}

void naechsteRast() {
  wartendHalt = false;
  int next = aktiveRast + 1;
  if (next < rastAnzahl) {
    rastStarten(next);
  } else {
    zustand    = GESTOPPT;
    aktiveRast = -1;
    heizungAus();
    kuehlungSetzen(false, true);
    logAktiv   = false;  // Log stoppen nach letzter Rast
    buzzerRuf(5);
    Serial.println("[INFO] Brauprogramm abgeschlossen!");
  }
}

// ── TEMPERATUR LESEN ─────────────────────────────────────────
float tempHistorie[6] = {0};  // letzte 6 Messungen à 2s = 12s Fenster
uint8_t tempHistIdx = 0;

void tempLesen() {
  unsigned long jetzt = millis();
  if (jetzt - letztesTempRead < TEMP_INTERVAL) return;
  letztesTempRead = jetzt;
  // Letztes Ergebnis lesen (non-blocking)
  float t = sensors.getTempCByIndex(0);
  // Neue Messung starten für nächsten Aufruf
  sensors.requestTemperatures();
  if (t != DEVICE_DISCONNECTED_C) {
    // Sensor OK
    if (sensorFehler) {
      sensorFehler = false;
      Serial.println("[SENSOR] Sensor wieder verbunden");
    }
    sensorFehlerZaehler = 0;
    tempHistorie[tempHistIdx] = t;
    tempHistIdx = (tempHistIdx + 1) % 6;
    float oldest = tempHistorie[tempHistIdx];
    if (oldest > 0.0) {
      tempGradient = (t - oldest) / 12.0 * 60.0;
    }
    tempAktuell = t;
    pidInput    = t;
  } else {
    // Sensor getrennt
    sensorFehlerZaehler++;
    if (sensorFehlerZaehler == 5) {  // 5 × 2s = 10s
      sensorFehler = true;
      heizungAus();
      Serial.println("[FEHLER] Sensor getrennt — Heizung gestoppt!");
      buzzerRuf(5);
    }
  }
  logPunkt();
}

// ── PID / HEIZUNG ────────────────────────────────────────────
void heizungRegeln() {
  // SICHERHEIT: Bei Sensorfehler NIEMALS heizen —
  // pidInput wäre veraltet, PID würde blind mit 100% weiterheizen
  if (sensorFehler) {
    pidOutput = 0;
    myPID.SetMode(MANUAL);
    heizungAus();
    kuehlungSetzen(false, true);
    return;
  }
  if (zustand == GESTOPPT) {
    // Auch im Stopp-Zustand regelmäßig AUS senden (Test-Schaltungen fallen so nach RC_REPEAT_MS zurück)
    unsigned long jetzt = millis();
    if (jetzt - letztesSenden >= RC_REPEAT_MS) {
      schalteAus();
      heizungAn     = false;
      letztesSenden = jetzt;
    }
    if (jetzt - kuehlLetztesSenden >= RC_REPEAT_MS) {
      kuehlSenden(false);
      kuehlungAn         = false;
      kuehlLetztesSenden = jetzt;
    }
    return;
  }
  // ── Kühlung (Hysterese) ─────────────────────────────────
  uint8_t modus = (aktiveRast >= 0 && aktiveRast < rastAnzahl) ? rasten[aktiveRast].modus : 0;
  if (modus >= 1) {
    if      (pidInput > pidSetpoint + kuehlHyst) kuehlungSetzen(true);
    else if (pidInput <= pidSetpoint)            kuehlungSetzen(false);
    else                                         kuehlungSetzen(kuehlungAn);  // Totzone: halten
  } else {
    kuehlungSetzen(false, true);
  }
  // Nur Kühlen, oder Kühlung läuft gerade → Heizung sicher aus
  if (modus == 1 || kuehlungAn) {
    pidOutput = 0;
    myPID.SetMode(MANUAL);
    heizungAus();
    return;
  }
  // ── Temperaturregelung ─────────────────────────────────
  double diff = pidSetpoint - pidInput;

  if (pidUeberschreitung > 0.0 && diff < -pidUeberschreitung) {
    // ÜBERSCHRITTEN → AUS, Integral einfrieren
    pidOutput = 0;
    myPID.SetMode(MANUAL);
  } else if (pidSchwellwert > 0.0 && diff > pidSchwellwert) {
    // WEIT UNTER SOLL → 100%, Integral einfrieren (kein Windup)
    pidOutput = 100.0;
    myPID.SetMode(MANUAL);
  } else {
    // IM REGELBEREICH → PID übernimmt (sanfter Übergang)
    if (myPID.GetMode() == MANUAL) {
      myPID.SetMode(AUTOMATIC);
    }
    myPID.Compute();
  }

  // ── MaxGradient berücksichtigen ──────────────────────────
  // Wenn aktive Rast einen MaxGradient > 0 hat, PID-Output begrenzen
  double pidOutputBegrenzt = pidOutput;
  if (aktiveRast >= 0 && aktiveRast < rastAnzahl) {
    float maxGrad = rasten[aktiveRast].maxGradient;
    if (maxGrad > 0.0) {
      // Aktueller Gradient zu hoch → Leistung reduzieren
      if (tempGradient > maxGrad) {
        // Linear zurückregeln: je mehr Überschreitung, desto weniger Leistung
        float ueberschreitung = tempGradient - maxGrad;
        float reduktion = ueberschreitung / maxGrad * 100.0;
        pidOutputBegrenzt = max(0.0, pidOutput - reduktion);
        Serial.printf("[GRAD] Gradient %.1f°C/min > Max %.1f°C/min — PID %0.f%% → %.0f%%\n",
          tempGradient, maxGrad, pidOutput, pidOutputBegrenzt);
      }
    }
    // maxGradient == 0 → keine Begrenzung, volle Leistung erlaubt
  }

  unsigned long jetzt   = millis();
  unsigned long fenster = jetzt - pidWindowStart;
  if (fenster >= PID_WINDOW_MS) {
    // Auf aktuelle Zeit setzen — verhindert Fenster-Springen
    // falls der Loop mal länger blockiert war
    pidWindowStart = jetzt;
    fenster = 0;
  }
  unsigned long einschaltMs = (unsigned long)(pidOutputBegrenzt / 100.0 * PID_WINDOW_MS);
  if (fenster < einschaltMs) heizungEin();
  else                        heizungAus();
}

// ── BRAU-LOGIK ───────────────────────────────────────────────
void brauLogik() {
  if (zustand == GESTOPPT || aktiveRast < 0) return;
  Rast& r = rasten[aktiveRast];
  unsigned long jetzt = millis();

  // ── AUFHEIZEN: Warte bis Solltemperatur erreicht ──────────
  if (zustand == AUFHEIZEN) {
    bool erreicht = (rastRichtung > 0) ? (tempAktuell >= pidSetpoint)
                                       : (tempAktuell <= pidSetpoint);
    if (erreicht) {
      // Temperatur erreicht → Timer sofort starten
      zustand     = RAST_LAEUFT;
      rastStartMs = jetzt;
      Serial.printf("[START] Rast %d laeuft — %.1f°C erreicht\n",
                    aktiveRast, tempAktuell);
    }
    return;
  }

  // ── WARTEN AUF WEITER (nach Call) ──────────────────────────
  if (zustand == WARTEN_HALT) {
    // Alle 30s wiederholen wenn nicht stumm
    if (!callMuted && (millis() - letzterCallPiep >= 10000)) {
      buzzerRuf(3);
      letzterCallPiep = millis();
      Serial.printf("[CALL] Wiederholung Rast %d\n", aktiveRast);
    }
    return;
  }

  // ── RAST LÄUFT: Timer überwachen ───────────────────────────
  if (zustand == RAST_LAEUFT) {
    if (jetzt - rastStartMs >= rastDauerMs) {
      Serial.printf("[ENDE] Rast %d abgeschlossen\n", aktiveRast);
      if (r.call) {
        // Call=true: Piepen + warten auf Weiter-Bestätigung
        buzzerRuf(3);
        letzterCallPiep = millis();
        zustand     = WARTEN_HALT;
        wartendHalt = true;
        Serial.printf("[CALL] Rast %d: warte auf Weiter\n", aktiveRast);
      } else {
        // Call=false: direkt zur nächsten Rast
        naechsteRast();
      }
    }
  }
}

// ── API: STATUS ──────────────────────────────────────────────
// Bewusst klein: wird alle 2s gepollt. Die Rasten-Liste gibt es
// separat unter /api/rezept; "rezeptVersion" sagt dem Browser,
// wann er sie neu laden muss.
void apiStatus() {
  StaticJsonDocument<768> doc;
  doc["api"]          = API_VERSION;
  doc["rezeptVersion"] = rezeptVersion;
  doc["temp"]       = tempAktuell;
  doc["soll"]       = pidSetpoint;
  doc["gradient"]   = tempGradient;
  doc["pidOut"]     = pidOutput;
  doc["heizung"]    = heizungAn;
  doc["kuehlung"]   = kuehlungAn;
  doc["richtung"]   = rastRichtung;
  doc["zustand"]    = (int)zustand;
  doc["rast"]       = aktiveRast;
  doc["rastAnzahl"] = rastAnzahl;
  doc["wartHalt"]   = wartendHalt;
  doc["sensorFehler"] = sensorFehler;
  doc["logAktiv"]   = logAktiv;
  doc["callMuted"]  = callMuted;
  if (aktiveRast >= 0 && aktiveRast < rastAnzahl) {
    Rast& r = rasten[aktiveRast];
    doc["rastName"]  = r.name;
    doc["rastInfo"]  = r.info;
    doc["rastSoll"]  = r.sollTemp;
    doc["rastDauer"] = r.time;
    doc["rastModus"] = r.modus;
    if (zustand == RAST_LAEUFT) {
      unsigned long verg   = (millis() - rastStartMs) / 1000;
      unsigned long gesamt = rastDauerMs / 1000;
      doc["timerVergangen"] = verg;
      doc["timerGesamt"]    = gesamt;
      doc["timerRest"]      = (gesamt > verg) ? (gesamt - verg) : 0;
    }
  }
  String json;
  serializeJson(doc, json);
  server.send(200, "application/json", json);
}

// ── API: REZEPT ──────────────────────────────────────────────
void apiRezeptGet() {
  DynamicJsonDocument doc(8192);
  doc["version"] = rezeptVersion;
  JsonArray liste = doc.createNestedArray("rasten");
  for (int i = 0; i < rastAnzahl; i++) {
    JsonObject o = liste.createNestedObject();
    o["nr"]          = i;
    o["name"]        = rasten[i].name;
    o["soll"]        = rasten[i].sollTemp;
    o["time"]        = rasten[i].time;
    o["halt"]        = rasten[i].halt;
    o["call"]        = rasten[i].call;
    o["ownPid"]      = rasten[i].ownPid;
    o["kp"]          = rasten[i].kp;
    o["ki"]          = rasten[i].ki;
    o["kd"]          = rasten[i].kd;
    o["maxGradient"] = rasten[i].maxGradient;
    o["modus"]       = rasten[i].modus;
    o["minTemp"]     = rasten[i].minTemp;
    o["maxTemp"]     = rasten[i].maxTemp;
    o["info"]        = rasten[i].info;
    yield();
  }
  String json;
  serializeJson(doc, json);
  server.send(200, "application/json", json);
}

void apiRezeptPost() {
  Serial.printf("[HTTP] POST /api/rezept — Client: %s\n",
    server.client().remoteIP().toString().c_str());
  if (zustand != GESTOPPT) {
    server.send(409, "application/json", "{\"error\":\"Brauvorgang läuft — erst stoppen\"}");
    return;
  }
  if (!server.hasArg("plain") || !rezeptSpeichern(server.arg("plain"))) {
    server.send(400, "application/json", "{\"error\":\"Rezept-JSON ungültig oder leer\"}");
    return;
  }
  server.send(200, "application/json",
    "{\"ok\":true,\"rasten\":" + String(rastAnzahl) + "}");
}

// ── API: LOG ────────────────────────────────────────────────
// Das Chart liest /api/log/download (CSV-Stream) direkt — kein JSON im RAM.
void apiLogReset() {
  logReset();
  server.send(200, "application/json", "{\"ok\":true}");
}

// ── API: FLASH LOG DOWNLOAD ──────────────────────────────────
void apiLogDownload() {
  if (!LittleFS.exists("/log.csv")) {
    server.send(404, "text/plain", "Kein Log vorhanden");
    return;
  }
  File f = LittleFS.open("/log.csv", "r");
  server.sendHeader("Content-Disposition", "attachment; filename=braulog.csv");
  server.streamFile(f, "text/csv");
  f.close();
}

// ── API: FILE LISTING ────────────────────────────────────────
void apiFiles() {
  String json = "[";
  bool first = true;
  Dir dir = LittleFS.openDir("/");
  while (dir.next()) {
    yield();
    if (dir.fileName() == "wlan.json") continue;  // geschützt
    if (!first) json += ",";
    json += "{\"name\":\"" + dir.fileName() + "\"," +
            "\"size\":" + String(dir.fileSize()) + "}";
    first = false;
  }
  json += "]";
  server.send(200, "application/json", json);
}

// ── API: FILE DELETE ─────────────────────────────────────────
void apiFileDelete() {
  if (!server.hasArg("name")) {
    server.send(400, "application/json", "{\"error\":\"name fehlt\"}");
    return;
  }
  String name = "/" + server.arg("name");
  // Sicherheit: wlan.json nicht löschbar (würde AP-Modus auslösen)
  if (name == "/wlan.json") {
    server.send(403, "application/json", "{\"error\":\"wlan.json geschützt — WLAN-Reset nutzen\"}");
    return;
  }
  if (!LittleFS.exists(name)) {
    server.send(404, "application/json", "{\"error\":\"Datei nicht gefunden\"}");
    return;
  }
  LittleFS.remove(name);
  Serial.printf("[FS] Gelöscht: %s\n", name.c_str());
  server.send(200, "application/json", "{\"ok\":true}");
}

// ── API: SETTINGS BACKUP ─────────────────────────────────────
void apiSettingsBackup() {
  if (!LittleFS.exists("/config.json")) {
    server.send(404, "text/plain", "Keine Einstellungen vorhanden");
    return;
  }
  File f = LittleFS.open("/config.json", "r");
  server.sendHeader("Content-Disposition", "attachment; filename=brewbrick_config.json");
  server.streamFile(f, "application/json");
  f.close();
}

// ── API: STEUERUNG ───────────────────────────────────────────
void apiStart() {
  Serial.printf("[HTTP] POST /api/start — Client: %s\n",
    server.client().remoteIP().toString().c_str());
  if (rastAnzahl == 0) {
    server.send(400, "application/json", "{\"error\":\"Kein Rezept geladen\"}");
    return;
  }
  int von = 0;
  if (server.hasArg("plain")) {
    StaticJsonDocument<64> doc;
    deserializeJson(doc, server.arg("plain"));
    von = doc["von"] | 0;
  }
  rastStarten(von);
  server.send(200, "application/json", "{\"ok\":true}");
}

void apiStop() {
  Serial.printf("[HTTP] POST /api/stop — Client: %s\n",
    server.client().remoteIP().toString().c_str());
  zustand    = GESTOPPT;
  aktiveRast = -1;
  heizungAus();
  kuehlungSetzen(false, true);
  logAktiv   = false;  // Log stoppen
  logStartMs = 0;      // Nächster Start → neues Log
  Serial.println("[LOG] Log gestoppt");
  server.send(200, "application/json", "{\"ok\":true}");
}

void apiCallMute() {
  callMuted = true;
  Serial.printf("[CALL] Stumm für Rast %d\n", aktiveRast);
  server.send(200, "application/json", "{\"ok\":true}");
}

void apiWeiter() {
  Serial.printf("[HTTP] POST /api/weiter — Client: %s\n",
    server.client().remoteIP().toString().c_str());
  if (wartendHalt) {
    wartendHalt = false;
    Serial.printf("[WEITER] Rast %d bestätigt — nächste Rast\n", aktiveRast);
    naechsteRast();
  }
  server.send(200, "application/json", "{\"ok\":true}");
}

// ── API: CONFIG ──────────────────────────────────────────────
void apiConfigGet() {
  DynamicJsonDocument doc(2048);
  doc["rcOn"]    = rcCodeOn;
  doc["rcOff"]   = rcCodeOff;
  doc["rcProto"] = rcProtocol;
  doc["rcPulse"] = rcPulse;
  doc["rcBits"]  = rcBits;
  doc["rcWdh"]   = rcWiederholungen;
  doc["Kp"]         = Kp;
  doc["Ki"]         = Ki;
  doc["Kd"]         = Kd;
  doc["pidFenster"]   = (int)(PID_WINDOW_MS / 1000);
  doc["pidSample"]    = pidSampleMs;
  doc["logIntervall"] = (int)(logIntervallMs / 1000);
  doc["logDelta"]     = logDeltaC;
  doc["pidSchwelle"]        = pidSchwellwert;
  doc["pidUeberschreitung"] = pidUeberschreitung;
  doc["rcRepeat"]     = (int)(RC_REPEAT_MS / 1000);
  doc["rcMinSchalt"]  = (int)RC_MIN_SCHALT_MS;
  doc["schaltModus"]   = schaltModus;
  doc["restStrikt200"] = restStrikt200;
  for (int i = 0; i < MAX_REST; i++) {
    char key[10];
    snprintf(key, sizeof(key), "restEn%d", i);
    doc[key] = restEnabled[i];
  }
  doc["tsAktiv"]     = tsAktiv;
  doc["tsKey"]       = (const char*)tsKey;
  doc["tsChannel"]   = tsChannel;
  doc["tsIntervall"] = (int)(tsIntervallMs / 1000);
  doc["tsNurBrauen"] = tsNurBrauen;
  doc["kRcOn"]       = kRcOn;
  doc["kRcOff"]      = kRcOff;
  doc["kUrlOn"]      = (const char*)kUrlOn;
  doc["kUrlOff"]     = (const char*)kUrlOff;
  doc["kuehlTyp"]    = kuehlTyp;
  doc["kuehlHyst"]   = kuehlHyst;
  doc["kuehlMinAn"]  = (int)(kuehlMinAnMs / 1000);
  doc["kuehlMinAus"] = (int)(kuehlMinAusMs / 1000);
  String json;
  serializeJson(doc, json);
  server.send(200, "application/json", json);
}

// ── API: THINGSPEAK ──────────────────────────────────────────
void tsStatusJson(JsonDocument& doc) {
  doc["aktiv"]    = tsAktiv;
  doc["status"]   = (const char*)tsStatus;
  doc["entry"]    = tsLetzteEntry;
  doc["fehler"]   = tsFehler;
  doc["alter"]    = tsLetzterErfolg ? (long)((millis() - tsLetzterErfolg) / 1000) : -1;
  doc["channel"]  = tsChannel;
}

void apiThingSpeakGet() {
  StaticJsonDocument<384> doc;
  tsStatusJson(doc);
  String json;
  serializeJson(doc, json);
  server.send(200, "application/json", json);
}

void apiThingSpeakTest() {
  bool ok = thingSpeakSenden(true);
  StaticJsonDocument<384> doc;
  doc["ok"] = ok;
  tsStatusJson(doc);
  if (!ok) doc["error"] = (const char*)tsStatus;
  String json;
  serializeJson(doc, json);
  server.send(200, "application/json", json);
}

void apiConfigPost() {
  Serial.printf("[HTTP] POST /api/config — Client: %s\n",
    server.client().remoteIP().toString().c_str());
  configSpeichern(server.arg("plain"));
  server.send(200, "application/json", "{\"ok\":true}");
}

void apiKuehlungTest() {
  if (server.hasArg("plain")) {
    StaticJsonDocument<64> doc;
    deserializeJson(doc, server.arg("plain"));
    kuehlungSetzen(doc["an"] | false, true);
  }
  server.send(200, "application/json", "{\"ok\":true}");
}

void apiHeizungTest() {
  if (server.hasArg("plain")) {
    StaticJsonDocument<64> doc;
    deserializeJson(doc, server.arg("plain"));
    bool an = doc["an"] | false;
    if (an) heizungEin(); else heizungAus();
  }
  server.send(200, "application/json", "{\"ok\":true}");
}

// REST-Steckdosen Config lesen
void apiRestGet() {
  DynamicJsonDocument doc(3072);
  doc["schaltModus"] = schaltModus;
  for (int i = 0; i < MAX_REST; i++) {
    char key[10];
    snprintf(key, sizeof(key), "restEn%d", i);
    doc[key] = restEnabled[i];
  }
  JsonArray arr = doc.createNestedArray("dosen");
  for (int i = 0; i < MAX_REST; i++) {
    JsonObject o = arr.createNestedObject();
    o["name"]   = restDosen[i].name;
    o["urlOn"]  = restDosen[i].urlOn;
    o["urlOff"] = restDosen[i].urlOff;
  }
  String json;
  serializeJson(doc, json);
  server.send(200, "application/json", json);
}

// REST-Steckdosen Config speichern
void apiRestPost() {
  String body = server.arg("plain");
  restDosenSpeichern(body);
  // schaltModus + restEnabled aus dem Body übernehmen
  DynamicJsonDocument doc(3072);
  if (deserializeJson(doc, body) == DeserializationError::Ok) {
    schaltModus   = doc["schaltModus"]   | schaltModus;
    restStrikt200 = doc["restStrikt200"] | restStrikt200;
    for (int i = 0; i < MAX_REST; i++) {
      char key[10];
      snprintf(key, sizeof(key), "restEn%d", i);
      if (doc.containsKey(key)) restEnabled[i] = doc[key];
    }
    // In config.json persistieren
    DynamicJsonDocument cfg(2048);
    File cf = LittleFS.open("/config.json", "r");
    if (cf) { deserializeJson(cfg, cf); cf.close(); }
    cfg["schaltModus"]   = schaltModus;
    cfg["restStrikt200"] = restStrikt200;
    for (int i = 0; i < MAX_REST; i++) {
      char key[10];
      snprintf(key, sizeof(key), "restEn%d", i);
      cfg[key] = restEnabled[i];
    }
    cf = LittleFS.open("/config.json", "w");
    if (cf) { serializeJson(cfg, cf); cf.close(); }
  }
  server.send(200, "application/json", "{\"ok\":true}");
}

// REST-Steckdose testen (?dose=0&an=true)
void apiRestTest() {
  int dose = server.hasArg("dose") ? server.arg("dose").toInt() : 0;
  bool an  = server.hasArg("an") ? (server.arg("an") == "true") : true;
  if (dose < 0 || dose >= MAX_REST) {
    server.send(400, "application/json", "{\"error\":\"ungültige Dose\"}");
    return;
  }
  bool ok = restCall(an ? restDosen[dose].urlOn : restDosen[dose].urlOff);
  String r = "{\"ok\":" + String(ok ? "true" : "false") + "}";
  server.send(200, "application/json", r);
}

File uploadFile;

// ── UPLOAD: CONFIG JSON ───────────────────────────────────────
void handleConfigUpload() {
  HTTPUpload& upload = server.upload();
  if (upload.status == UPLOAD_FILE_START) {
    Serial.println("[UPLOAD] Config Start");
    LittleFS.remove("/config.json");
    uploadFile = LittleFS.open("/config.json", "w");
  }
  else if (upload.status == UPLOAD_FILE_WRITE) {
    if (uploadFile) uploadFile.write(upload.buf, upload.currentSize);
  }
  else if (upload.status == UPLOAD_FILE_END) {
    if (uploadFile) uploadFile.close();
    Serial.printf("[UPLOAD] Config Ende: %u Bytes\n", upload.totalSize);
    configLaden();  // Sofort übernehmen
  }
}

void handleConfigUploadEnd() {
  server.send(200, "application/json", "{\"ok\":true}");
}

// ── UPLOAD: INDEX.HTML ───────────────────────────────────────
void handleHtmlUpload() {
  HTTPUpload& upload = server.upload();
  if (upload.status == UPLOAD_FILE_START) {
    // .gz oder .html erkennen
    bool isGz = upload.filename.endsWith(".gz");
    String fname = isGz ? "/index.html.gz" : "/index.html";
    Serial.printf("[UPLOAD] %s Start\n", fname.c_str());
    LittleFS.remove("/index.html");
    LittleFS.remove("/index.html.gz");
    uploadFile = LittleFS.open(fname, "w");
  }
  else if (upload.status == UPLOAD_FILE_WRITE) {
    if (uploadFile) uploadFile.write(upload.buf, upload.currentSize);
  }
  else if (upload.status == UPLOAD_FILE_END) {
    if (uploadFile) uploadFile.close();
    Serial.printf("[UPLOAD] HTML Ende: %u Bytes\n", upload.totalSize);
  }
}

void handleHtmlUploadEnd() {
  bool ok = LittleFS.exists("/index.html") || LittleFS.exists("/index.html.gz");
  if (ok)
    server.send(200, "application/json", "{\"ok\":true,\"msg\":\"HTML gespeichert\"}");
  else
    server.send(500, "application/json", "{\"error\":\"Speichern fehlgeschlagen\"}");
}

void handleHtmlReset() {
  LittleFS.remove("/index.html");
  LittleFS.remove("/index.html.gz");
  server.send(200, "application/json", "{\"ok\":true,\"msg\":\"PROGMEM Version aktiv\"}");
  Serial.println("[HTML] LittleFS HTML geloescht — Setup-Seite aktiv");
}

// ── SETUP ────────────────────────────────────────────────────
void setup() {
  Serial.begin(115200);
  Serial.println("\n[BOOT] Brausteuerung startet...");

  // ── GPIO0 / Flash-Knopf: als Output (Buzzer) ────────────
  pinMode(PIN_BUZZER, OUTPUT);
  digitalWrite(PIN_BUZZER, LOW);
  pinMode(PIN_LED, OUTPUT);
  digitalWrite(PIN_LED, HIGH);  // aus (active-low)

  // ── LittleFS ────────────────────────────────────────────
  if (!LittleFS.begin()) {
    Serial.println("[ERROR] LittleFS Fehler!");
  } else {
    Serial.println("[FS] LittleFS OK");

    configLaden();
    if (rezeptLaden())
      Serial.printf("[REZEPT] %d Rasten geladen\n", rastAnzahl);
  }

  // ── Sensoren & Hardware ──────────────────────────────────
  sensors.begin();
  sensors.setWaitForConversion(false);  // Nicht blockieren!
  sensors.setResolution(10);            // 10-bit = ~188ms statt 750ms
  Serial.printf("[TEMP] %d Sensor(en)\n", sensors.getDeviceCount());

  rcSwitch.enableTransmit(PIN_RCSWITCH);
  rcSwitch.setProtocol(rcProtocol);
  rcSwitch.setPulseLength(rcPulse);

  myPID.SetMode(AUTOMATIC);
  myPID.SetOutputLimits(0, 100);
  myPID.SetSampleTime(pidSampleMs);   // aus config.json, Standard 2000 ms

  // ── WLAN ────────────────────────────────────────────────
  WiFi.hostname(HOSTNAME);
  bool hatConfig = wlanConfigLaden();

  if (hatConfig) {
    // Gespeicherte Credentials → verbinden versuchen
    Serial.printf("[WIFI] Verbinde mit: %s\n", wlanSSID.c_str());
    WiFi.mode(WIFI_STA);
    WiFi.begin(wlanSSID.c_str(), wlanPassword.c_str());

    int tries = 0;
    while (WiFi.status() != WL_CONNECTED && tries < 30) {
      digitalWrite(PIN_LED, LOW);  delay(100);
      digitalWrite(PIN_LED, HIGH); delay(400);
      Serial.print("."); tries++;
      yield();
    }
    Serial.println();

    if (WiFi.status() == WL_CONNECTED) {
      Serial.printf("[WIFI] Verbunden: http://%s.local  (%s)\n",
                    HOSTNAME, WiFi.localIP().toString().c_str());
      MDNS.begin(HOSTNAME);
      apModus = false;
    } else {
      Serial.println("[WIFI] Verbindung fehlgeschlagen → AP-Modus");
      apModus = true;
    }
  } else {
    Serial.println("[WIFI] Keine Config → AP-Modus");
    apModus = true;
  }

  // AP-Modus starten falls nötig
  if (apModus) {
    WiFi.mode(WIFI_AP);
    WiFi.softAP("BrewBrick");  // Offen, kein Passwort
    Serial.printf("[AP] SSID: BrewBrick (offen) | IP: %s\n",
                  WiFi.softAPIP().toString().c_str());
    // mDNS auch im AP-Modus starten
    MDNS.begin(HOSTNAME);
    Serial.printf("[mDNS] http://%s.local erreichbar\n", HOSTNAME);
    // Nur AP-Routen registrieren
    apRoutenSetup();
    server.begin();
    Serial.println("[HTTP] AP-Server gestartet — warte auf WLAN-Einrichtung");
    // Buzzer: langes Summen = AP-Modus
    digitalWrite(PIN_BUZZER, HIGH); delay(300); digitalWrite(PIN_BUZZER, LOW);
    return;  // Normales Setup überspringen
  }

  // ── NORMALE ROUTEN (WLAN verbunden) ─────────────────────
  server.on("/", HTTP_GET, []() {
    Serial.printf("[HTTP] GET / — Client: %s\n",
      server.client().remoteIP().toString().c_str());
    if (LittleFS.exists("/index.html.gz")) {
      File f = LittleFS.open("/index.html.gz", "r");
      server.sendHeader("Content-Encoding", "gzip");
      server.streamFile(f, "text/html");
      f.close();
    } else if (LittleFS.exists("/index.html")) {
      File f = LittleFS.open("/index.html", "r");
      server.streamFile(f, "text/html");
      f.close();
    } else {
      // Noch keine index.html — Setup-Seite anzeigen
      server.send_P(200, "text/html", SETUP_HTML);
    }
  });

  server.on("/api/status",       HTTP_GET,  apiStatus);
  server.on("/api/start",        HTTP_POST, apiStart);
  server.on("/api/stop",         HTTP_POST, apiStop);
  server.on("/api/weiter",       HTTP_POST, apiWeiter);
  server.on("/api/call/mute",    HTTP_POST, apiCallMute);
  server.on("/api/config",       HTTP_GET,  apiConfigGet);
  server.on("/api/config",       HTTP_POST, apiConfigPost);
  server.on("/api/heizung-test", HTTP_POST, apiHeizungTest);
  server.on("/api/kuehlung-test", HTTP_POST, apiKuehlungTest);
  server.on("/api/rezept",       HTTP_GET,  apiRezeptGet);
  server.on("/api/rezept",       HTTP_POST, apiRezeptPost);
  server.on("/api/rest",         HTTP_GET,  apiRestGet);
  server.on("/api/rest",         HTTP_POST, apiRestPost);
  server.on("/api/rest/test",    HTTP_POST, apiRestTest);
  server.on("/api/thingspeak",      HTTP_GET,  apiThingSpeakGet);
  server.on("/api/thingspeak/test", HTTP_POST, apiThingSpeakTest);
  server.on("/api/log/reset",       HTTP_POST, apiLogReset);
  server.on("/api/log/download",    HTTP_GET,  apiLogDownload);
  server.on("/api/settings/backup", HTTP_GET,  apiSettingsBackup);
  server.on("/api/files",           HTTP_GET,  apiFiles);
  server.on("/api/files/delete",    HTTP_POST, apiFileDelete);
  server.on("/api/rezept/loeschen", HTTP_POST, []() {
    rezeptLoeschen();
    server.send(200, "application/json", "{\"ok\":true}");
  });
  server.on("/api/wlan/reset",   HTTP_POST, []() {
    Serial.println("[WLAN] Reset per Web-UI — lösche alle Dateien und starte neu");
    server.send(200, "application/json", "{\"ok\":true}");
    delay(500);
    // Alle Dateien löschen
    Dir dir = LittleFS.openDir("/");
    while (dir.next()) {
      LittleFS.remove("/" + dir.fileName());
      Serial.printf("[FS] Gelöscht: %s\n", dir.fileName().c_str());
      yield();
    }
    ESP.restart();
  });
  server.on("/tools", HTTP_GET, []() {
    Serial.printf("[HTTP] GET /tools — Client: %s\n",
      server.client().remoteIP().toString().c_str());
    server.send_P(200, "text/html", TOOLS_HTML);
  });

  server.on("/upload/config", HTTP_POST, handleConfigUploadEnd, handleConfigUpload);
  server.on("/upload/html",   HTTP_POST, handleHtmlUploadEnd,   handleHtmlUpload);
  server.on("/upload/html-reset", HTTP_GET, handleHtmlReset);

  // OTA Firmware Update unter /update (GET=Formular, POST=Upload)
  otaServer.setup(&server, "/update", "admin", "brau2024");
  Serial.println("[OTA] Firmware-Update verfügbar unter /update");

  // System-Info API
  server.on("/api/sysinfo", HTTP_GET, []() {
    StaticJsonDocument<256> doc;
    doc["freeHeap"]      = ESP.getFreeHeap();
    doc["flashSize"]     = ESP.getFlashChipSize();
    doc["sketchSize"]    = ESP.getSketchSize();
    doc["freeSketch"]    = ESP.getFreeSketchSpace();
    doc["uptime"]        = millis() / 1000;
    doc["version"]       = FW_VERSION;
    doc["api"]           = API_VERSION;
    doc["ip"]            = WiFi.localIP().toString();
    doc["hostname"]      = HOSTNAME;
    doc["htmlLittleFS"]  = LittleFS.exists("/index.html");
    FSInfo fs;
    LittleFS.info(fs);
    doc["fsTotal"]       = fs.totalBytes;
    doc["fsUsed"]        = fs.usedBytes;
    String json;
    serializeJson(doc, json);
    server.send(200, "application/json", json);
  });

  // wlan.json explizit sperren
  server.on("/wlan.json", HTTP_GET, []() {
    server.send(403, "text/plain", "Forbidden");
  });

  server.onNotFound([]() {
    Serial.printf("[HTTP] 404 %s — Client: %s\n",
      server.uri().c_str(), server.client().remoteIP().toString().c_str());
    server.send(404, "text/plain", "Not found");
  });

  server.begin();
  Serial.println("[HTTP] Server gestartet");
  buzzerRuf(2);
  Serial.println("[BOOT] Bereit!");
}

// ── LOOP ─────────────────────────────────────────────────────
unsigned long letztesTempLog = 0;
void loop() {
  server.handleClient();
  MDNS.update();
  tempLesen();
  heizungRegeln();
  brauLogik();
  ledUpdate();
  thingSpeakSenden();
  // Temperatur alle 30s ins Serial loggen
  if (millis() - letztesTempLog >= 30000) {
    letztesTempLog = millis();
    Serial.printf("[TEMP] Ist: %.1f°C | Soll: %.1f°C | Gradient: %.1f°C/min | PID: %.0f%% | Heap: %u B\n",
      tempAktuell, pidSetpoint, tempGradient, pidOutput, ESP.getFreeHeap());
  }
}
