sky4walk/BrausteuerungV4/Software/src/hw_test/settings.h

// brausteuerung@AndreBetz.de
#ifndef __SETTINGS__
#define __SETTINGS__

#include <Arduino.h>
#define MAXRAST             16
///////////////////////////////////////////////////////////////////////////////
// settings
///////////////////////////////////////////////////////////////////////////////
class Settings
{
  public:
    Settings()
    {
      params.mKalT              = 0.0f;
      params.mKalM              = 1.0f;
      params.mOnT               = 26.1f;
      params.mOffT              = 27.1f;
      params.onOff              = false;
      params.shouldSave         = false;
      params.switchOn           = 1631343;
      params.switchOff          = 1631342;
      params.switchProtocol     = 1;
      params.switchPulseLength  = 315;
      params.switchBits         = 24;
      params.switchRepeat       = 15;
      params.restartEsp         = false;
    }
    float getKalT() 
    {
      return params.mKalT;
    }
    void setKalT(float kaltT) 
    {
      params.mKalT = kaltT;
    }
    float getKalM() 
    {
      return params.mKalM;
    }
    void setKalM(float kaltM) 
    {
      params.mKalM = kaltM;
    }
    float getOnT() 
    {
      return params.mOnT;
    }
    void setOnT(float onT) 
    {
      params.mOnT = onT;
    }
    float getOffT() 
    {
      return params.mOffT;
    }
    void setOffT(float offT) 
    {
      params.mOffT = offT;
    }
    void setWebPassWd(String webPassWd) {
      params.webPassWd = webPassWd;
    }
    String getWebPassWd() {
      return params.webPassWd;
    }
    float getActTemp(){
      return params.actTemp;
    }
    void setActTemp(float actTemp){
      params.actTemp = actTemp;
    }
    bool getOnOff() {
      return params.onOff;
    }
    void setOnOff(bool onOff) {
      params.onOff = onOff;
    }
    bool getShouldSave() {
      return params.shouldSave;
    }
    void setShouldSave(bool shouldSave) {
      params.shouldSave = shouldSave;
    }
    String getPassWd() {
      return params.passWd;
    }
    void setPassWd(String passWd) {
      params.passWd = passWd;
    }
    int getSwitchOn() {
      return params.switchOn;
    }
    void setSwitchOn(int switchOn) {
      params.switchOn = switchOn;
    }
    int getSwitchOff() {
      return params.switchOff;
    }
    void setSwitchOff(int switchOff) {
      params.switchOff = switchOff;
    }
    int getSwitchBits() {
      return params.switchBits;
    }
    void setSwitchBits(int switchBits) {
      params.switchBits = switchBits;
    }
    int getSwitchProtocol() {
      return params.switchProtocol;
    }
    void setSwitchProtocol(int switchProtocol) {
      params.switchProtocol = switchProtocol;
    }
    int getSwitchPulseLength() {
      return params.switchPulseLength;
    }
    void setSwitchPulseLength(int switchPulseLength) {
      params.switchPulseLength = switchPulseLength;
    }
    int getSwitchRepeat() {
      return params.switchRepeat;
    }
    void setSwitchRepeat(int switchRepeat) {
      params.switchRepeat = switchRepeat;
    }
    bool getRestartEsp() {
      return params.restartEsp;
    }
    void setRestartEsp(bool restartEsp) {
      params.restartEsp = restartEsp;
    }
  private:
    
    struct
    {
      float mKalT;
      float mKalM;
      float mOnT;
      float mOffT;
      bool doubleReset;
      String webPassWd;  
      float actTemp;
      bool onOff;
      bool shouldSave;
      String passWd;
      int switchOn;
      int switchOff;
      int switchProtocol;
      int switchPulseLength;
      int switchBits;
      int switchRepeat;
      bool restartEsp;
    } params;
};
#endif
