sky4walk/BrausteuerungV4/(commit log)

2017-07-26 start with a fritzing scheme
    [BrausteuerungV4.fzz]
2017-07-26 added switch
    [BrausteuerungV4.fzz]
2017-07-26 added ds18b20
    [BrausteuerungV4.fzz]
2017-07-26 added ds18b20 to fritzing
    [BrausteuerungV4.fzz]
2017-07-26 changes some HW parts because ESP8266 has a built in volatge measuring ESP.getVC()
    [Bauteilliste.ods, BrausteuerungV4.fzz]
2017-08-02 added resistor to LED
    [BrausteuerungV4.fzz]
2017-08-04 bautilliste mit 220ohm widerstand
    [Bauteilliste.ods]
2023-09-25 start kicad layout
    [BrausteuerungV4_Prototypplatine.kicad_pcb, BrausteuerungV4_Prototypplatine.kicad_sch, BrausteuerungV4b.fzz]
2023-09-26 added PCB
    [BrausteuerungV4_Prototypplatine.kicad_pcb, BrausteuerungV4b.fzz]
2023-09-26 gerber created to send to elecrow
    [BrausteuerungV4_Prototypplatine-B_Cu.gbr, BrausteuerungV4_Prototypplatine-B_Mask.gbr, BrausteuerungV4_Prototypplatine-B_Paste.gbr, BrausteuerungV4_Prototypplatine-B_Silkscreen.gbr, BrausteuerungV4_Prototypplatine-Edge_Cuts.gbr, BrausteuerungV4_Prototypplatine-F_Cu.gbr, BrausteuerungV4_Prototypplatine-F_Mask.gbr, BrausteuerungV4_Prototypplatine-F_Paste.gbr]
2023-11-06 case ready
    [Box.scad, Box.stl]
2023-11-10 new box dimensions
    [Box.scad, Box.stl]
2023-11-11 some mods
    [Box.scad, Box.stl]
2023-11-14 box as a brick
    [Box.scad, Box.stl]
2023-11-14 bigger USB micro opening size
    [Box.scad, Box.stl]
2023-11-14 reset hole positioned
    [Box.scad, Box.stl]
2023-11-18 AsyncWebServer switched
    [Box.scad]
2023-11-25 changed reset opening
    [Box.scad, Box.stl]
2023-11-27 separate box and lid
    [Box.scad, Box.stl, Lid.stl]
2023-12-04 get toggle switch state
2023-12-11 added PID cycle setting and beautify json settings
2023-12-13 some changes and added knob
    [Box.scad, Box.stl, Knob.stl]
2023-12-14 changed sizes of box
    [Box.scad, Box.stl, Knob.stl]
2023-12-14 RF 433MHz receiver
    [RF Transmitter attiny85 Receiver arduino uno.fzz, TX433MHz-Receiver.fzz]
2023-12-17 bug in PID
2023-12-19 support 16 rasten
    [Box.scad]
2023-12-19 added bin and changed knob length
    [Box.scad]
2024-06-25 holder for AA6
    [holder.scad, holder.stl]
2024-07-04 bug fixes because of new libraries
    [holder.scad, holder.stl]
2026-05-03 reduced to needed stuff
    [BrausteuerungV4.fzz]
2026-05-03 including rezept import und editor
2026-05-03 bug fix reset wifi
    [Steuerung.ino]
2026-05-04 small changes and small fixes
    [Steuerung.ino]
2026-05-06 changes in receiver
    [TX433MHz-Receiver.fzz]
2026-05-06 new HW receiver
    [TX433MHz-Receiver-MX-RM-5V.fzz]
2026-05-07 new switch codes
2026-05-18 changed temp sensor to async
2026-05-18 blinkende led zeigt netzwerk zustand
2026-06-10 changes in PID
2026-09-27 mit kühlung
    [Box.scad, Box.stl]
